FabLabUChile/modi/README.md

modi
====

cheap and fast building robot for swarm behavior research
