FabLabUChile/modi/Software/README.txt

### Software/README ###

The software section is divided in the tracking system and the software wich controls the MODI robot.

## Software/Tracking/ ##

Contains the fiducials images and software to track the MODI robot position from an online video input.

## Software/MODI/ ##

Contains the software to be loaded into the arduino onboard each MODI module.
