FabLabUChile/modi/thesis/main.tex

% LaTeX Template
% Version 1.3 (21/12/12)
%
% This template has been downloaded from:
% http://www.latextemplates.com
%
% Original authors:
% Steven Gunn 
% http://users.ecs.soton.ac.uk/srg/softwaretools/document/templates/
% and
% Sunil Patel
% http://www.sunilpatel.co.uk/thesis-template/
%
% License:
% CC BY-NC-SA 3.0 (http://creativecommons.org/licenses/by-nc-sa/3.0/)
%
% Note:
% Make sure to edit document variables in the Thesis.cls file
%
%%%%%%%%%%%%%%%%%%%%%%%%%%%%%%%%%%%%%%%%%

%----------------------------------------------------------------------------------------
%	PACKAGES AND OTHER DOCUMENT CONFIGURATIONS
%----------------------------------------------------------------------------------------

\documentclass[11pt, a4paper, oneside]{Thesis} % Paper size, default font size and one-sided paper

\usepackage[utf8]{inputenc}
\usepackage[section]{placeins}

\graphicspath{{./Pictures/}} % Specifies the directory where pictures are stored

\usepackage[square, numbers, comma, sort&compress]{natbib} % Use the natbib reference package - read up on this to edit the reference style; if you want text (e.g. Smith et al., 2012) for the in-text references (instead of numbers), remove 'numbers' 
\hypersetup{urlcolor=blue, colorlinks=true} % Colors hyperlinks in blue - change to black if annoying
\title{\ttitle} % Defines the thesis title - don't touch this

\begin{document}

\frontmatter % Use roman page numbering style (i, ii, iii, iv...) for the pre-content pages

\setstretch{1.3} % Line spacing of 1.3

% Define the page headers using the FancyHdr package and set up for one-sided printing
\fancyhead{} % Clears all page headers and footers
\rhead{\thepage} % Sets the right side header to show the page number
\lhead{} % Clears the left side page header

\pagestyle{fancy} % Finally, use the "fancy" page style to implement the FancyHdr headers

\newcommand{\HRule}{\rule{\linewidth}{0.5mm}} % New command to make the lines in the title page

% PDF meta-data
\hypersetup{pdftitle={\ttitle}}
\hypersetup{pdfsubject=\subjectname}
\hypersetup{pdfauthor=\authornames}
\hypersetup{pdfkeywords=\keywordnames}

%----------------------------------------------------------------------------------------
%	TITLE PAGE
%----------------------------------------------------------------------------------------

\begin{center}
\linespread{1.15}
\textbf{\large{UNIVERSIDAD TÉCNICA FEDERICO SANTA MARÍA\\}
\normalsize{DEPARTAMENTO DE ELECTRÓNICA\\VALPARAÍSO - CHILE\\}}

\vspace{0.5cm}
\begin{figure}[!ht]
\centering
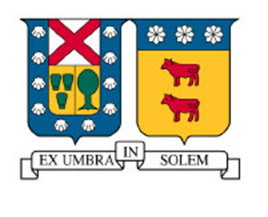
[picture p1: thesis/Figures/usmLogo.png]
  
\end{figure}
\vspace{0.5cm}

\linespread{1}\hangindent=0cm
\textbf{\Large ``DISEÑO Y CONSTRUCCIÓN DE PLATAFORMA PARA ESTUDIO DE ENJAMBRES DE ROBOTS''\\}
\vspace{3cm}

\hangindent=0cm\large \textbf{SEBASTIÁN IGNACIO SÁEZ SAN JUAN}\\
\vspace{0.5cm}
\hangindent=0cm\normalsize \textbf{MEMORIA DE TITULACIÓN PARA OPTAR AL TÍTULO DE INGENIERO CIVIL ELECTRÓNICO}\\
\vspace{3cm}

\vspace{0.5cm}
\begin{figure}[!ht]
\centering
  
\end{figure}
\vspace{0.5cm}

%\hangindent=0cm\normalsize \textbf{PROFESOR GUIA: \hspace{1cm} DRA. MARÍA JOSE ESCOBAR}\\
%\vspace{0.5cm}
%\hangindent=0cm\normalsize \textbf{PROFESOR CORREFERENTE: \hspace{1cm} DR. PABLO PRIETO}\\
%\vspace{0.5cm}
%\hangindent=0cm\normalsize \textbf{PROFESOR CORREFERENTE: \hspace{1cm} DR. JUAN CRISTOBAL ZAGAL}\\

\end{center}
%
%\begin{center}
%
%\textsc{\LARGE \univname}\\[1.5cm] % University name
%\textsc{\Large Memoria Titulación}\\[0.5cm] % Thesis type
%
%\HRule \\[0.4cm] % Horizontal line
%{\huge \bfseries \ttitle}\\[0.4cm] % Thesis title
%\HRule \\[1.5cm] % Horizontal line
% 
%\begin{minipage}{0.4\textwidth}
%\begin{flushleft} \large
%\emph{Autor:}\\
%\end{flushleft}
%\end{minipage}
%\begin{minipage}{0.4\textwidth}
%\begin{flushright} \large
%\emph{Supervisores:} \\
%\end{flushright}
%\end{minipage}\\[3cm]
% 
%\large \textit{Memoria para optar al grado de \degreename}\\[0.3cm] % University requirement text
%\textit{en el}\\[0.4cm]
%\deptname\\[2cm] % Research group name and department name
% 
%{\large \today}\\[4cm] % Date
%%\includegraphics{Logo} % University/department logo - uncomment to place it
% 
%\vfill
%\end{center}

%----------------------------------------------------------------------------------------
%	DECLARATION PAGE
%	Your institution may give you a different text to place here
%----------------------------------------------------------------------------------------

%----------------------------------------------------------------------------------------
%	QUOTATION PAGE
%----------------------------------------------------------------------------------------

%----------------------------------------------------------------------------------------
%	ABSTRACT PAGE
%----------------------------------------------------------------------------------------

\addtotoc{Resumen} % Add the "Abstract" page entry to the Contents

\resumen{\addtocontents{toc}{\vspace{1em}} % Add a gap in the Contents, for aesthetics
Desarrollo de una plataforma, de bajo costo, que permita estudiar el comportamiento de grupos de robots. Para que la plataforma funcione es necesario el diseño y construcción de los robots , implementar sistema de tracking 2D, armar la red de comunicación (XBee) y construir el software de control.
}

\clearpage % Start a new page

%----------------------------------------------------------------------------------------
%	ABSTRACT PAGE
%----------------------------------------------------------------------------------------

\addtotoc{Abstract} % Add the "Abstract" page entry to the Contents

\abstract{\addtocontents{toc}{\vspace{1em}} % Add a gap in the Contents, for aesthetics
Create a low cost platform, which allows to study the behavior of a group of robots. For this platform to work, it is necessary the design and building of the robots, implement a 2D tracking system, build a communication network (xbee) and create the control software.
}

\clearpage % Start a new page

%----------------------------------------------------------------------------------------
%	ACKNOWLEDGEMENTS
%----------------------------------------------------------------------------------------

\setstretch{1.3} % Reset the line-spacing to 1.3 for body text (if it has changed)

\acknowledgements{\addtocontents{toc}{\vspace{1em}} % Add a gap in the Contents, for aesthetics 

Este trabajo no habría podido realizarse sin el apoyo incondicional de mi profesora tutora, Dra. María José Escobar que ha tenido una gran paciencia conmigo y siempre me ha ayudado en lo posible. También fue fundamental el apoyo del Dr. Juan Cristóbal Zagal que gentilmente me permitió trabajar en su innovador laboratorio de Síntesis de máquinas inteligentes. No menos importante fue el apoyo del Dr. Pablo Prieto que ha sido un guía para mí en el diseño del robot. Además de ellos conté con la ayuda de muchas personas que han dedicado parte de su tiempo a escuchar mis ideas y aconsejarme. Es por esto que quiero agradecer a Jaime Martínez por ayudarme a diseñar el PCB de MODI, Carlos Galáz por sus inacabables minutos telefónicos para discutir casi todos los aspectos de MODI, Fabián Rubilar por sus ideas de como mover los robots, Linus Casassa por su paciencia para explicarme cualquier cosa sobre electrónica, la gente del taller de electrónica por enseñarme a soldar y sacarme de apuros técnicos, Ricardo Pérez por las interminables discusiones sobre el robot, mis compañeros del laboratorio de Sintesís de máquinas inteligentes y a mi amada Pía que siempre ha estado ahí conmigo siendo un gran apoyo en mi vida.
}
\clearpage % Start a new page

%----------------------------------------------------------------------------------------
%	LIST OF CONTENTS/FIGURES/TABLES PAGES
%----------------------------------------------------------------------------------------

\pagestyle{fancy} % The page style headers have been "empty" all this time, now use the "fancy" headers as defined before to bring them back

\lhead{\emph{Contents}} % Set the left side page header to "Contents"
\tableofcontents % Write out the Table of Contents

\lhead{\emph{Índice de Figuras y Tablas}} % Set the left side page header to "List of Figures"
\listoffigures % Write out the List of Figures

%----------------------------------------------------------------------------------------
%	DEDICATION
%----------------------------------------------------------------------------------------

\setstretch{1.3} % Return the line spacing back to 1.3

\pagestyle{empty} % Page style needs to be empty for this page

\dedicatory{Pía, mi fiel compañera de aventuras\ldots} % Dedication text

\addtocontents{toc}{\vspace{2em}} % Add a gap in the Contents, for aesthetics
\addcontentsline{toc}{chapter}{Prefacio}

%----------------------------------------------------------------------------------------
%	THESIS CONTENT - CHAPTERS
%----------------------------------------------------------------------------------------

\mainmatter % Begin numeric (1,2,3...) page numbering

\pagestyle{fancy} % Return the page headers back to the "fancy" style

% Include the chapters of the thesis as separate files from the Chapters folder
% Uncomment the lines as you write the chapters

\input{./Chapters/Prefacio}
\input{./Chapters/Chapter1} 
\input{./Chapters/Chapter2}
\input{./Chapters/Chapter3}
\input{./Chapters/Chapter4} 
\input{./Chapters/Chapter5} 
\input{./Chapters/Chapter6}
\input{./Chapters/Chapter7}

%----------------------------------------------------------------------------------------
%	THESIS CONTENT - APPENDICES
%----------------------------------------------------------------------------------------

\addtocontents{toc}{\vspace{2em}} % Add a gap in the Contents, for aesthetics

\appendix % Cue to tell LaTeX that the following 'chapters' are Appendices

% Include the appendices of the thesis as separate files from the Appendices folder
% Uncomment the lines as you write the Appendices

\input{./Appendices/AppendixA}
%\input{./Appendices/AppendixB}
%\input{./Appendices/AppendixC}

\addtocontents{toc}{\vspace{2em}} % Add a gap in the Contents, for aesthetics

\backmatter

%----------------------------------------------------------------------------------------
%	BIBLIOGRAPHY
%----------------------------------------------------------------------------------------

\label{Bibliography}
%Renombrar pagina
\renewcommand{\bibname}{Referencias}
\renewcommand{\refname}{Referencias}

\lhead{\emph{Bibliography}} % Change the page header to say "Bibliography"

\bibliographystyle{unsrtnat} % Use the "unsrtnat" BibTeX style for formatting the Bibliography

\bibliography{Bibliography} % The references (bibliography) information are stored in the file named "Bibliography.bib"

\end{document}
