FabLabUChile/modi/thesis/Chapters/Chapter3.tex

% Chapter Template

\chapter{Swarm} % Main chapter title

\label{Chapter3} % Change X to a consecutive number; for referencing this chapter elsewhere, use \ref{ChapterX}

\lhead{Capítulo 3. \emph{Swarms}} % Change X to a consecutive number; this is for the header on each page - perhaps a shortened title

\begin{figure}[htbp]
	\centering
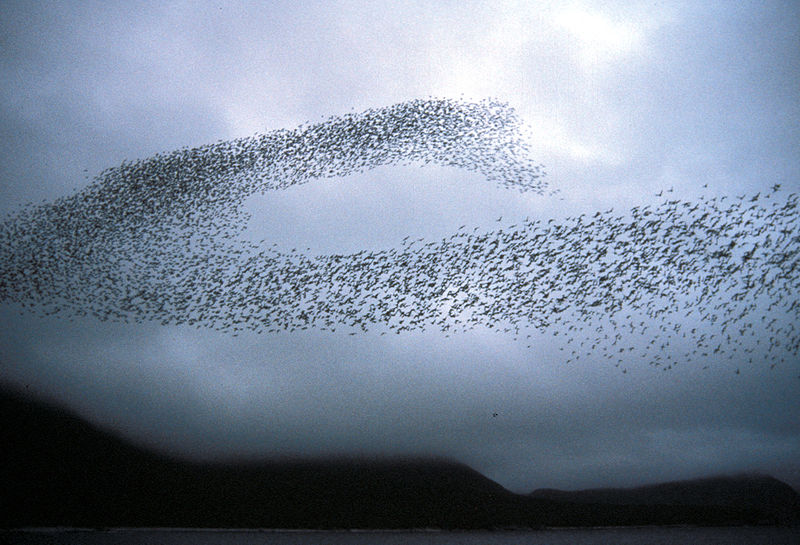
[picture p28: thesis/Figures/swarm.jpg]
		
	%	\rule{35em}{0.5pt}
	%\caption[Bandada de auklets]{Bandada de auklets teniendo comportamiento de enjambre. Imagen tomada de Wikipedia.}
	\label{fig:Bandada}
\end{figure}

El comportamiento colectivo de sistemas descentralizados, auto-organizados es llamado Inteligencia de Enjambre. Estos sistemas están formados típicamente por una población de individuos simples que interactúan entre ellos localmente y con su medio ambiente. Estos individuos siguen reglas muy simples, y pese a no tener una estructura de control centralizado que dicte cómo deben comportarse individualmente,  las interacciones entre los individuos conducen a la aparición de cierta inteligencia en el comportamiento global.

%----------------------------------------------------------------------------------------
%	SECTION 1
%----------------------------------------------------------------------------------------

\section{Comportamiento colectivo en la naturaleza}

En la naturaleza existen diversos casos de comportamiento colectivo. Los enjambres más típicos son las hormigas y abejas, pero los hay en peces, aves e incluso los mamíferos. Son sistemas donde nadie está a cargo y aún así ejecutan una tarea grupal. Las hormigas son un gran ejemplo. Al momento de construir su madriguera, no tienen un arquitecto o ingeniero estructural que esté dando órdenes, simplemente cada una sabe qué tiene que hacer. No hay un director orquestando la construcción desde lo alto, en vez de esto lo que ocurre es un comportamiento emergente. También conocido como inteligencia de enjambre\cite{bonabeau1999swarm}.

Otro tipo de comportamiento colectivo son las migraciones, desplazamientos periódicos que efectúan aves, peces, langostas y mamíferos de un hábitat a otro. Cada individuo activo en la migración sigue al grupo, los más pequeños como el plancton o anfibios aprovechan las corrientes de aire o agua, y las aves, más grandes, aprovechan los vientos y corrientes ascendentes. Hay diversas finalidades detrás de la migración, algunas especies lo hacen para escaparse de los crudos inviernos o secos veranos; mientras que otras, como las tortugas marinas, por una necesidad reproductiva emprenden un largo viaje de más de 10.000 millas, a lo largo de todo el Atlántico Norte.

Lograr que un enjambre de robots tenga un comportamiento emergente como el de las colonias de abejas es lo que están buscando investigadores de esta área. Uno de los más destacados investigadores del área James McLurkin, experto en robótica del Massachusetts Institute of Technology (MIT), dice que para lograrlo es necesario un software que ejecute tareas individuales y que de alguna forma se cumpla con una tarea grupal \cite{mclurkin2007distributed}. He aquí una importante razón para desarrollar estudios sobre enjambres de robots, ya que aún no está claro cómo se coordina la naturaleza para llevar a cabo tales tareas. Un ejemplo es el algoritmo Optimización de colonia de hormigas, que es una clase de algoritmos inspirado en las acciones de una colonia de hormigas y como hacen uso de la feromona. Su principal uso es en problemas donde se necesite encontrar caminos hacia una meta, simulando las feromonas para dirigir a cada uno de los individuos en la búsqueda. Utilizando este tipo de estrategia es posible que en un futuro no muy lejano se pueda utilizar para controlar nanobots dentro del cuerpo con el fin de eliminar los tumores del cáncer.

%-----------------------------------
%	SECTION 2
%-----------------------------------
\section{Robots para construir un enjambre}

Diferentes laboratorios del mundo han desarrollado robots que funcionan como enjambre, con diseños que satisface sus propios requerimientos. Dependiendo de ellos varían en costo, tamaño y funcionalidad.

Algunos robots que pueden ser utilizados para hacer un Robot Swarm junto con las información técnica disponible, son listados en la sub secciones siguientes.

%-----------------------------------
%	SUBSECTION 1
%-----------------------------------
\subsection{Kilobot}
El proyecto Kilobot, ver Figura \ref{fig:robots estudiados} a, es un sistema de bajo costo escalable para demostrar comportamientos colectivos. Actualmente el grupo Self-organizing Systems Research Group \footnote{http://www.eecs.harvard.edu/ssr/index.html} , de la Universidad de Harvard, está investigando algoritmos para enjambres de robots, por esto diseñó Kilobot, que es un robot de bajo costo, accesible,  que permite hacer pruebas en cientos o miles de robots. Con estos robots investigan temas como: encontrar "alimento" de forma grupal, seguir al líder y dispersarse unos de otro. Su principal característica es que son muy pequeños y simples de usar. Las desventajas de Kilobots son: su sistema de locomoción que obliga a tener una superficie extremadamente lisa para usarlos y que no poseen sistema de radio que permita en control de forma inalámbrica, solo comunicación local.

%-----------------------------------
%	SUBSECTION 2
%-----------------------------------
\subsection{Organismo Multibot}
S. Kornienko et al. \cite{5359578}, exploran el trabajo colaborativo en robots para un mejor rendimiento y mayor fiabilidad a nivel macroscópico. En este artículo demuestran sus últimos trabajos en sistemas colectivos y lo más sorprendente es que logran la agregación y desagregación autónoma para así obtener un organismo multibot. Este robot tiene la ventaja de tener un mecanismo que le permite unirse mecánicamente, pero también puede compartir energía, sensores y lógica con otros robots iguales para formar un organismo que es capaz de modificar su estructura y adaptarse al entorno auto-organizándose. En la Figura \ref{fig:robots estudiados} b, se puede ver una estructura formada por los robots. De los robots estudiados este es el único que posee esta capacidad de unirse de manera autónoma ya que su hardware fue concebido para tales fines, pero no representa una ventaja porque se acotó la búsqueda a robots con desplazamiento diferencial. Estos robots no cuentan con documentación detallada ni distribuidores que los vendan, al parecer están descontinuados.

%-----------------------------------
%	SUBSECTION 3
%-----------------------------------
\subsection{e-puck}
Uno de los robots más utilizados por los científicos en el mundo para estudios y publicaciones es el e-puck \cite{mondada2009puck}. Este robot es compacto, tiene forma de cilindro con un diámetro de 7 [cm] y para moverse hace uso de sus dos ruedas, dejándolo en la categoría de robot con desplazamiento diferencial. Originalmente fue diseñado para educar en el área de la micro ingeniería por Michael Bonani y Francesco Mondala en el laboratorio ASL del Profesor Roland Siegwart en Escuela Politécnica Federal de Lausana (EPFL) en Suiza. El e-puck es open hardware, su software es de código abierto,  lo construyen y venden varias empresas. Para comunicarse con un computador incorporan un módulo Bluetooth conectado a uno de sus dos puertos serie. Existen varios tipos de accesorios, entre los que destacan un Zigbee para comunicaciones, un módulo con varias cámaras y LEDs RGB como sistema de comunicación visual. Su principal desventaja es el alto precio y por lo mismo su uso está algo descontinuado. Además son complejos de programar y se necesita una licencia especial para su software.

%-----------------------------------
%	SUBSECTION 4
%-----------------------------------
\subsection{3pi Robot}

El 3pi fue diseñado especialmente como un robot seguidor de líneas y capaz de solucionar laberintos. Existen varios vídeos que muestran la asombrosa velocidad de estos robots para solucionar un laberinto \footnote{http://www.pololu.com/catalog/product/975}. Se programa en C, pero como posee un microcontrolador ATmega es posible hacer uso del bootloader Arduino y programarlo con ese IDE. Usa 4 baterías AAA y trae 4 LEDs.  Yi-Jen Mon1 utilizó estos robots para desarrollar Supervisory Adaptive Network-Based Fuzzy Inference System (SANFIS) de forma empírica en un robot móvil, no simulado en un computador. Sus desventajas son: No cuenta con un sistema de carga autónoma, hardware extra que no va ser necesario para nuestros experimentos, necesita un cable especial para programarlo y no tiene comunicación inalámbrica.

\begin{figure}[htbp]
	\centering
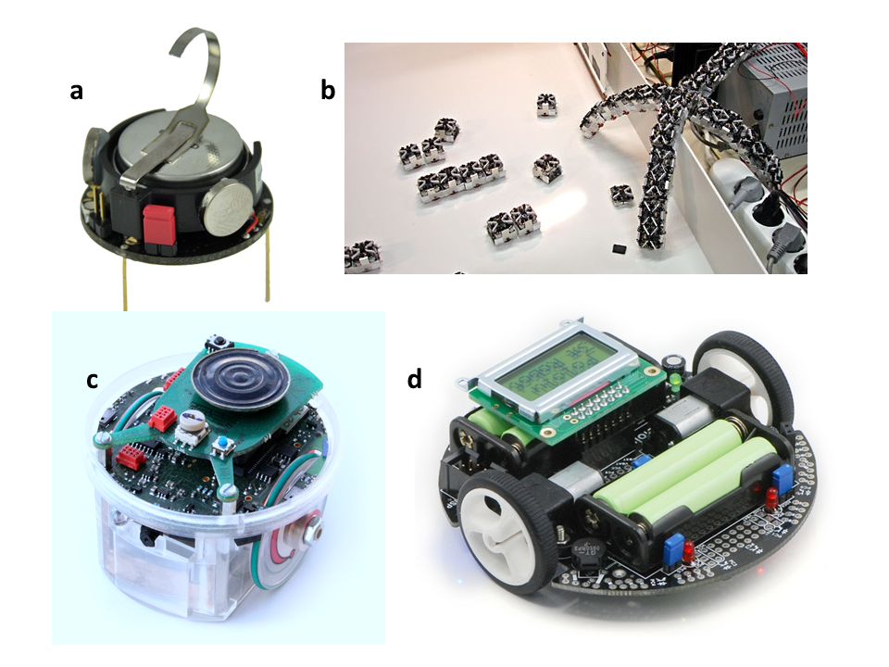
[picture p29: thesis/Figures/robots1.png]
		
		\rule{35em}{0.5pt} 
	\caption[Robots estudiados como alternativa para armar un enjambre de robots.]{\textbf{a.} Kilobot, el más simple de todos y pequeño. Imagen tomada de \cite{6224638}. \textbf{b.} Organismo Multibot, permite armar estructuras con los robots. Imagen tomada de \cite{5359578}. \textbf{c.} e-puck, robot altamente difundido en investigaciones, caro y complejo. Imagen tomada de \cite{mondada2009puck}. \textbf{d.} 3pi Robot, simple y económico pero no tiene comunicación inalámbrica. Imagen tomada de \cite{thurskyusing}}
	\label{fig:robots estudiados}
\end{figure}

En la Figura \ref{fig:Tabla robots} hay una tabla comparativa que resume las principales características de los robot: Kilobot\footnote{http://www.k-team.com/mobile-robotics-products/kilobot/specifications}, e-puck\footnote{http://www.gctronic.com/doc/index.php/E-Puck} y 3pi\footnote{http://www.pololu.com/catalog/product/975/specs}. Lamentablemente para el multibot no es mucha la información disponible.

\begin{figure}[htbp]
	\centering
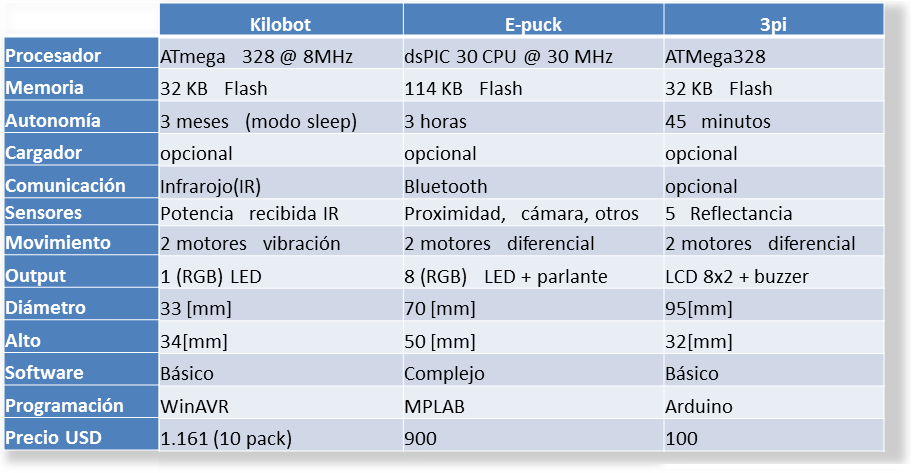
[picture p30: thesis/Figures/tabla_robots.png]
		
		\rule{35em}{0.5pt}
	\caption[Tabla comparativa robots]{En esta tabla se comparan las características principales de los robots: kilobot, e-puck y 3pi. No se incluyó el robot utilizado para el organismo multibot ya que no se comercializa.}
	\label{fig:Tabla robots}
\end{figure}

En esta tabla se comparan tres robots que pueden usarse para hacer estudios de enjambres de robots. De acá se resume que kilobot es un robot simple que no tiene comunicación inalámbrica, E-puck es un robot sumamente completo con un alto costo y está sobredimencionado para los estudios que se quieren hacer. El que más se acerca a nuestros requerimientos es el 3Pi de Pololu, pero cuenta con hardware extra que aumenta su consumo energético y no incorpora ningún sistema de comunicación inalámbrica.

\FloatBarrier
Además existen otros robots que podrían utilizarse en este trabajo, pero que al momento del desarrollo no existian. En el repositorio de objetos 3D de MakelBot Thingiverse existe algunos. Tres que destacan por su simplicidad son: SlinkyBOT Lunar mini rover \footnote{http://www.thingiverse.com/thing:98091} Ver Figura \ref{fig:thingiverse} b, Econo1Bot for the RAMB motherboards \footnote{http://www.thingiverse.com/thing:83998}  Ver Figura \ref{fig:thingiverse} c. y MiniSkybot \footnote{http://www.thingiverse.com/thing:7989}  Ver Figura \ref{fig:thingiverse} c.
 
\begin{figure}[htbp]
	\centering
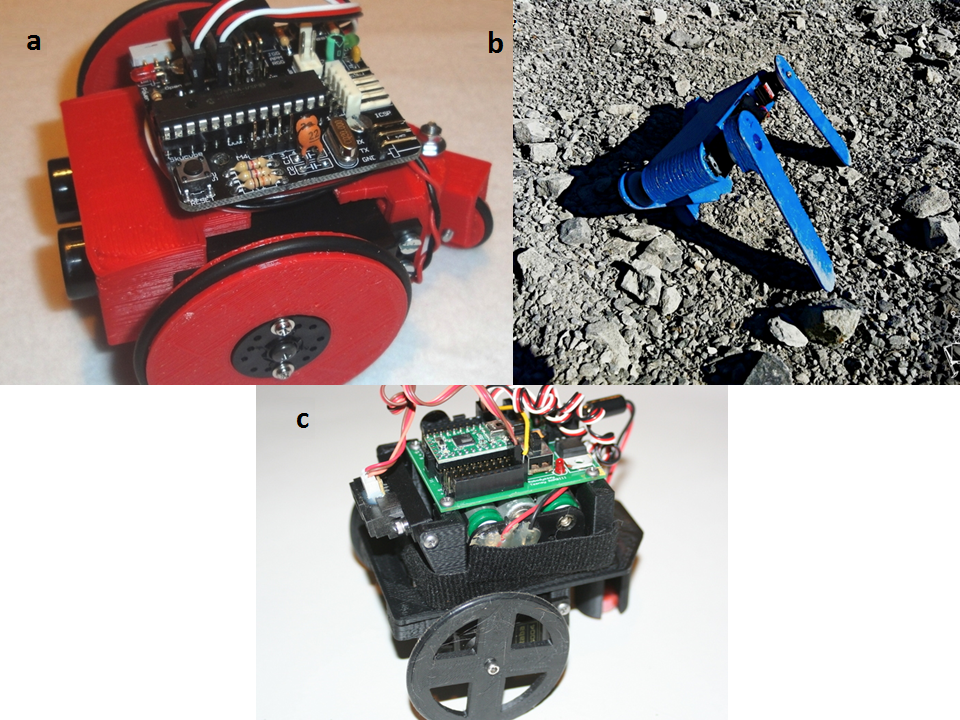
[picture p31: thesis/Figures/thingiverse.png]
		
		\rule{35em}{0.5pt}
	\caption[Robots en Thingiverse]{Robots que han sido subidos a la plataforma Thingiverse para que usuarios puedan descargar los modelos y construirlos. \textbf{a.} MiniSkybot, \textbf{b.}SlinkyBOT Lunar mini rover y \textbf{c.} Econo1Bot for the RAMB motherboards.}
	\label{fig:thingiverse}
\end{figure}

%-----------------------------------
%	SECTION 3
%-----------------------------------
\section{Necesidades de mercado}

De los robots estudiados destaca en sus prestaciones el e-puck, pero este tiene dos grandes problemas para ser usado por gente que no es especialista en robots. Uno es que tiene demasiado hardware, lo que tiende a confundir y aumentar costos. Dos, que para su comunicación inalámbrica hace uso de Bluetooth, protocolo que no soporta las redes Mesh para hacer de manera simple el control de muchos dispositivos en una red. Por otro lado el robot Kilobot es extremadamente simple, no permite mucha modificación y este con 3pi no tienen sistema de comunicación inalámbrica.

Hace falta un robot que no sobrepase los 200 USD, capaz de controlarse en forma inalámbrica, simple de construir y fácil de usar. Se requiere hacer uso de tecnologías como impresoras 3D y diseño Open Hardware para los robot que formen el enjambre. El tener un diseño compatible con las impresoras 3D facilita enormemente la difusión y distribución del proyecto, ya que cualquier persona con acceso a una impresora 3D puede replicar el robot. Y para hacer más simple el proceso de réplica y fomentar las mejoras en el proyecto, se requiere que tanto el hardware como el software sean Open, esto significa que cualquier persona puede acceder a los archivos de diseño del robot, copiarlos, redistribuirlo y modificarlo para que se adapte a sus necesidades. El nombre del robot será MODI que viene de las siglas del inglés Modular Intelligence. MODI quiere satisfacer el nicho de mercado donde se necesitan robots simples y de bajo precio, como se ve en la Figura \ref{fig:nicho}.

\begin{figure}[htbp]
	\centering
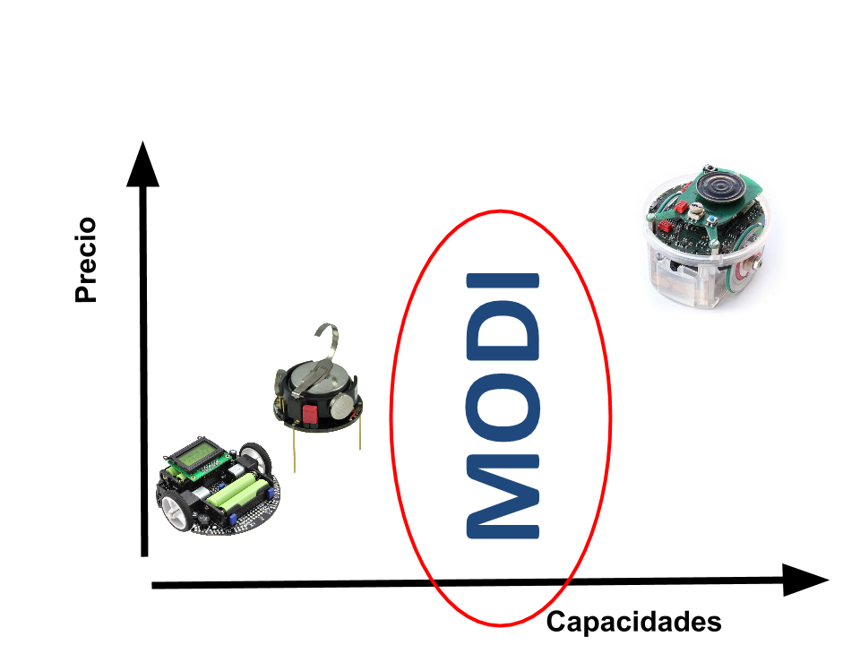
[picture p32: thesis/Figures/nicho.png]
		
		\rule{35em}{0.5pt}
	\caption[Nicho de mercado]{Nicho de mercado donde puede ingresar la plataforma robótica que se diseñó. Su nombre es MODI por las siglas en inglés de Modular Intelligence.}
	\label{fig:nicho}
\end{figure}
