FabLabUChile/modi/Hardware/Eagle/modi.png

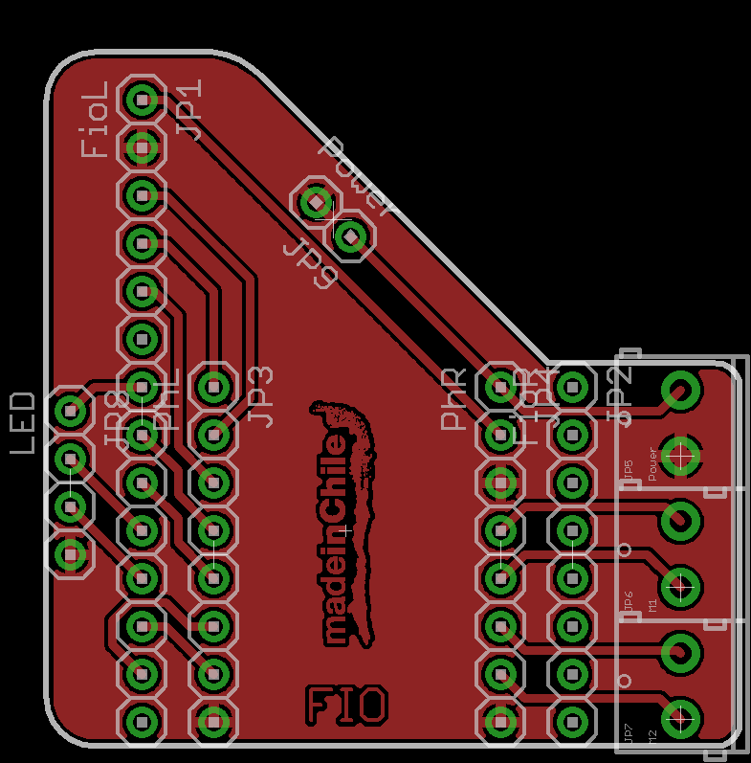
Hardware/Eagle/modi.png
