FabLabUChile/modi/Hardware/Eagle/MODIboard.png

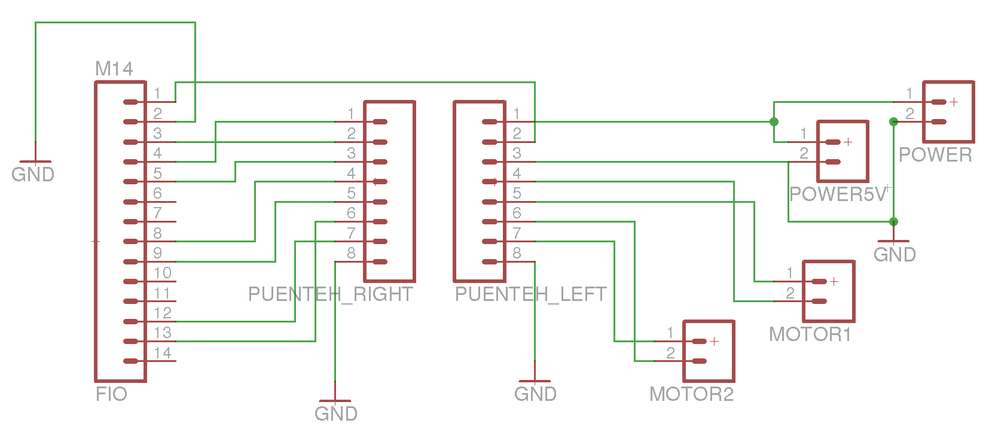
Hardware/Eagle/MODIboard.png
