FabLabUChile/modi/Hardware/Eagle/modiSLIM.png

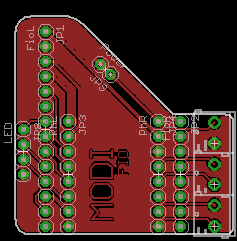
Hardware/Eagle/modiSLIM.png
