FabLabUChile/modi/Hardware/Eagle/TB6612FNG Breakout v11/TB6612FNG Breakout.png

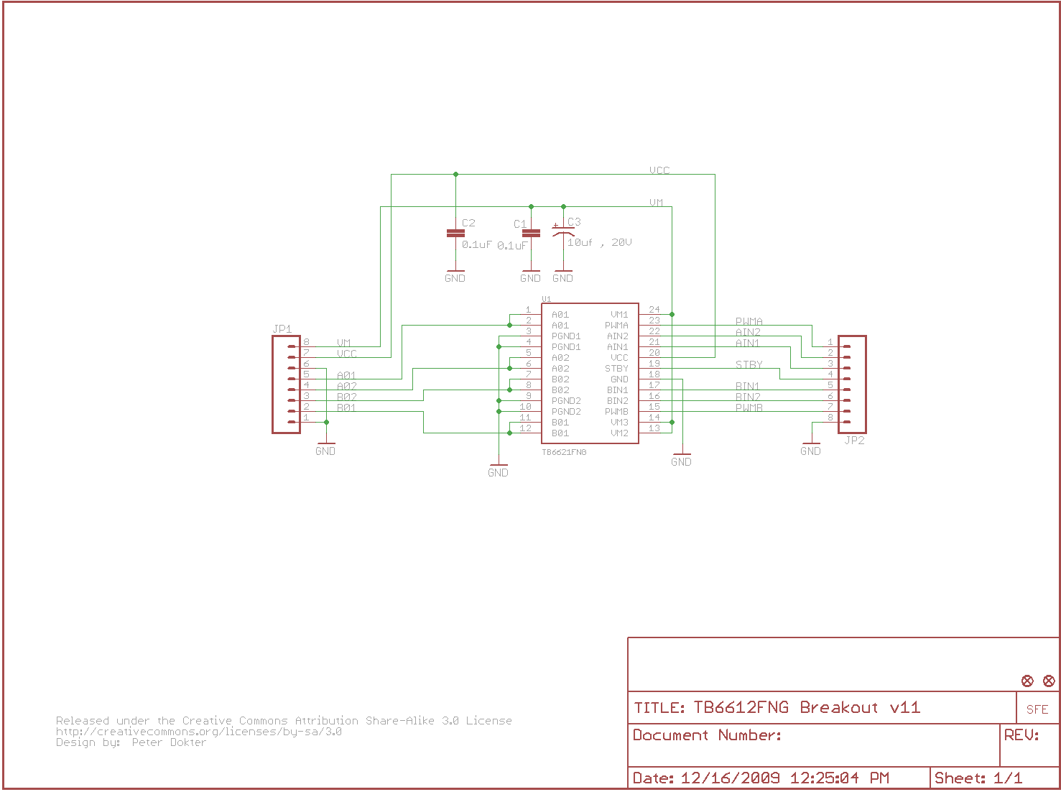
Hardware/Eagle/TB6612FNG Breakout v11/TB6612FNG Breakout.png
