FabLabUChile/modi/Media/images/pinocchio.jpg

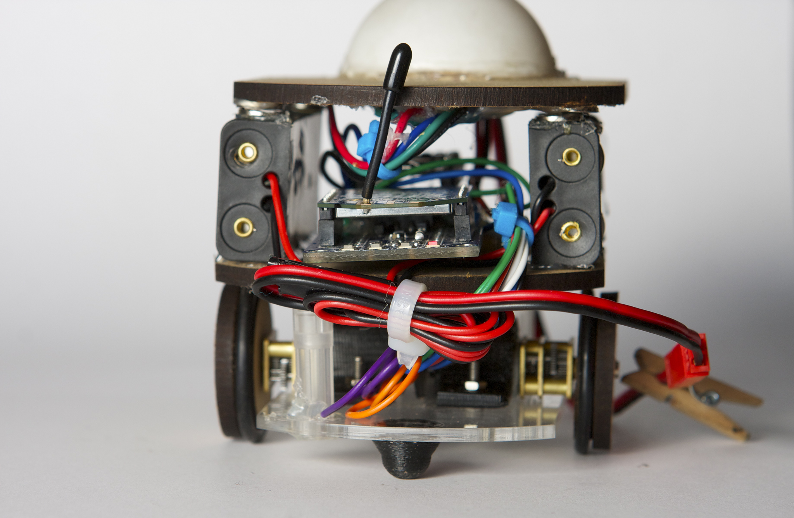
Media/images/pinocchio.jpg
