FabLabUChile/modi/thesis/Figures/3dtouch.jpg

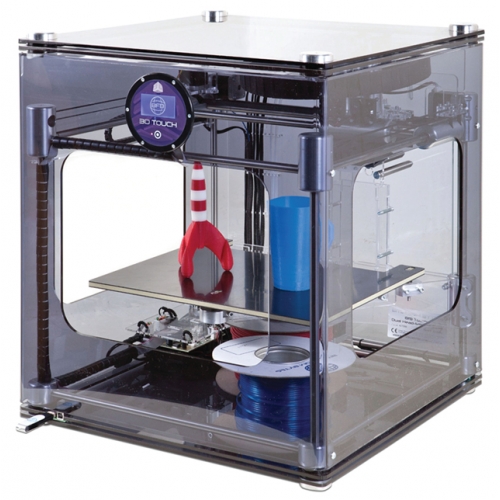
thesis/Figures/3dtouch.jpg
