FabLabUChile/modi/thesis/Figures/algoritmo_automodelo.png

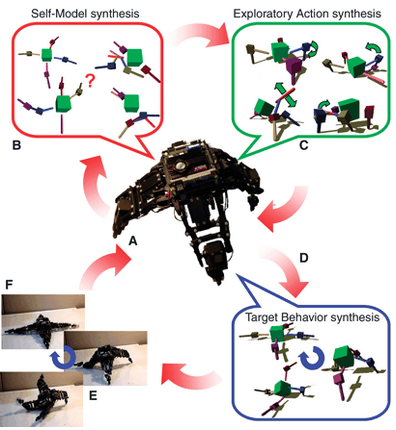
thesis/Figures/algoritmo_automodelo.png
