FabLabUChile/modi/thesis/Figures/arquitectura_cerebro.png

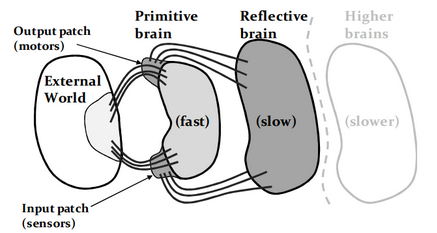
thesis/Figures/arquitectura_cerebro.png
