FabLabUChile/modi/thesis/Figures/automod.png

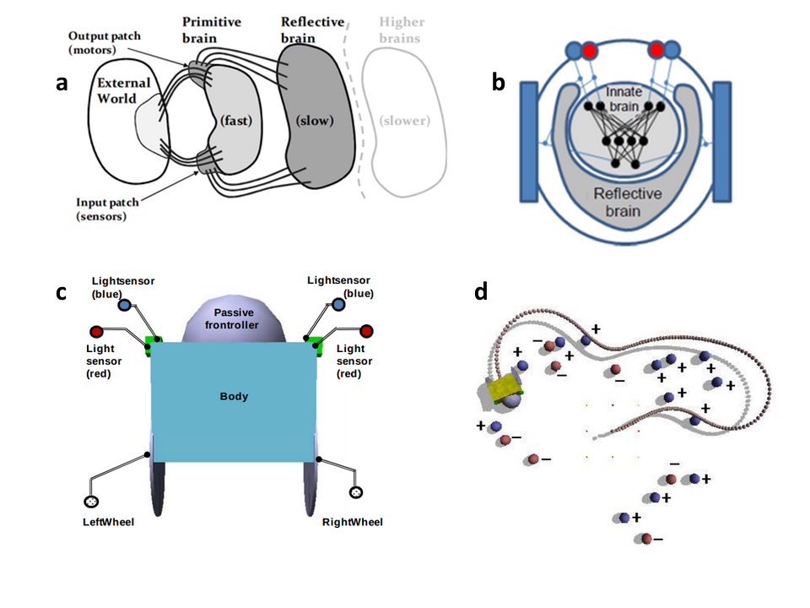
thesis/Figures/automod.png
