FabLabUChile/modi/thesis/Figures/automodelado_epuck.png

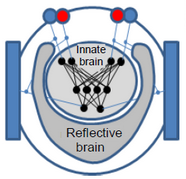
thesis/Figures/automodelado_epuck.png
