FabLabUChile/modi/thesis/Figures/Diagrama.jpg

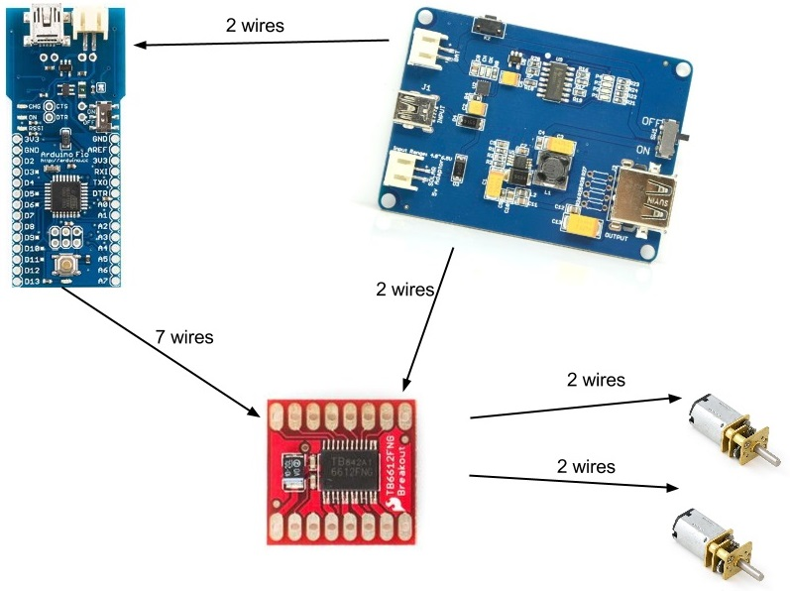
thesis/Figures/Diagrama.jpg
