FabLabUChile/modi/thesis/Figures/ExpPwm.png

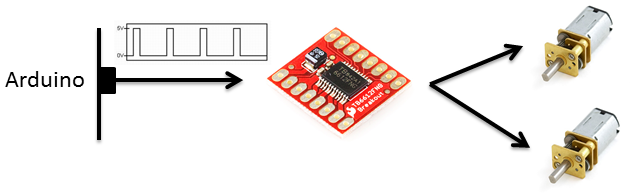
thesis/Figures/ExpPwm.png
