FabLabUChile/modi/thesis/Figures/implementacion.png

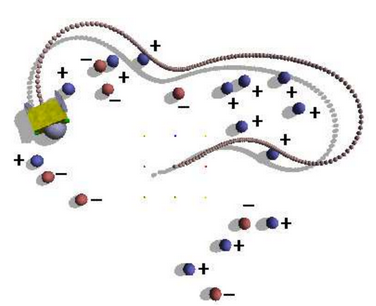
thesis/Figures/implementacion.png
