FabLabUChile/modi/thesis/Figures/MODI/1MODI.jpg

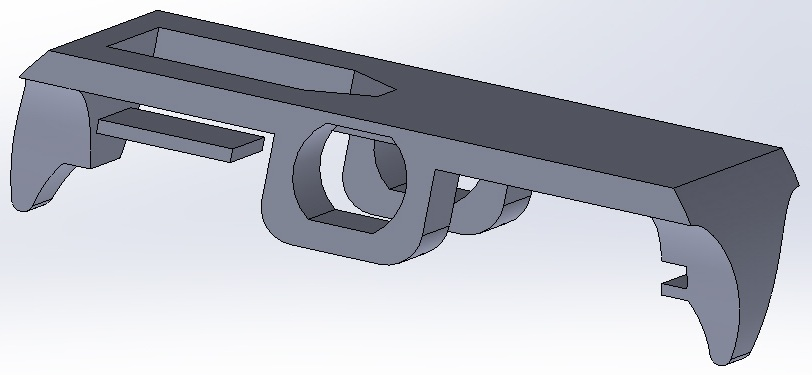
thesis/Figures/MODI/1MODI.jpg
