FabLabUChile/modi/thesis/Figures/MODI/accesorio.jpg

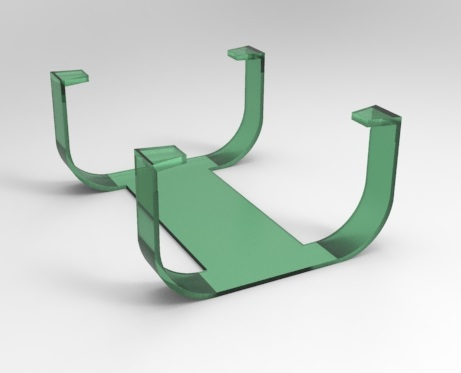
thesis/Figures/MODI/accesorio.jpg
