FabLabUChile/modi/thesis/Figures/MODI/bateria.jpg

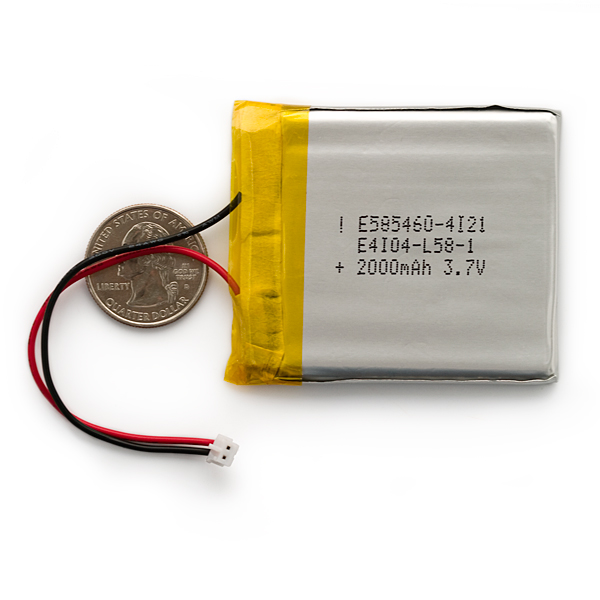
thesis/Figures/MODI/bateria.jpg
