FabLabUChile/modi/thesis/Figures/MODI/chasismodi.jpg

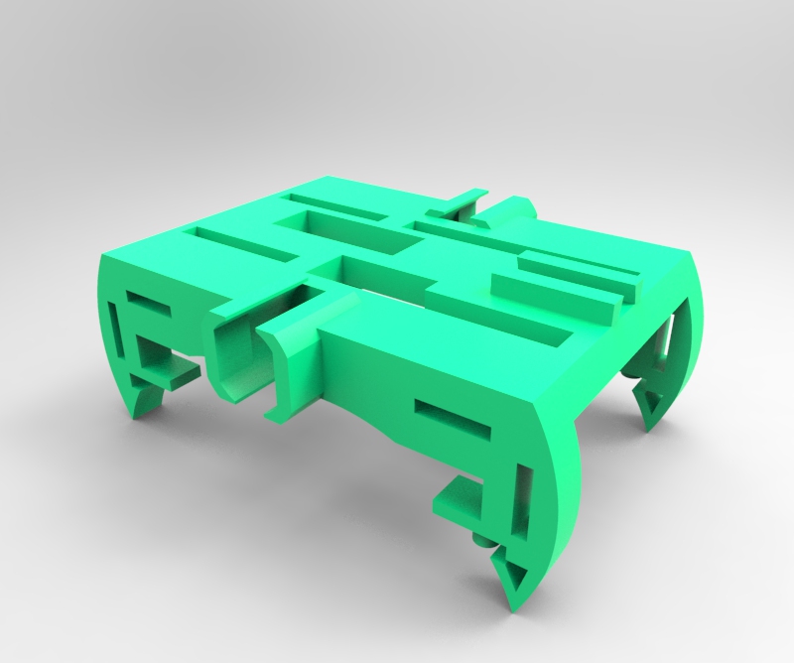
thesis/Figures/MODI/chasismodi.jpg
