FabLabUChile/modi/thesis/Figures/MODI/circuitoPCB.png

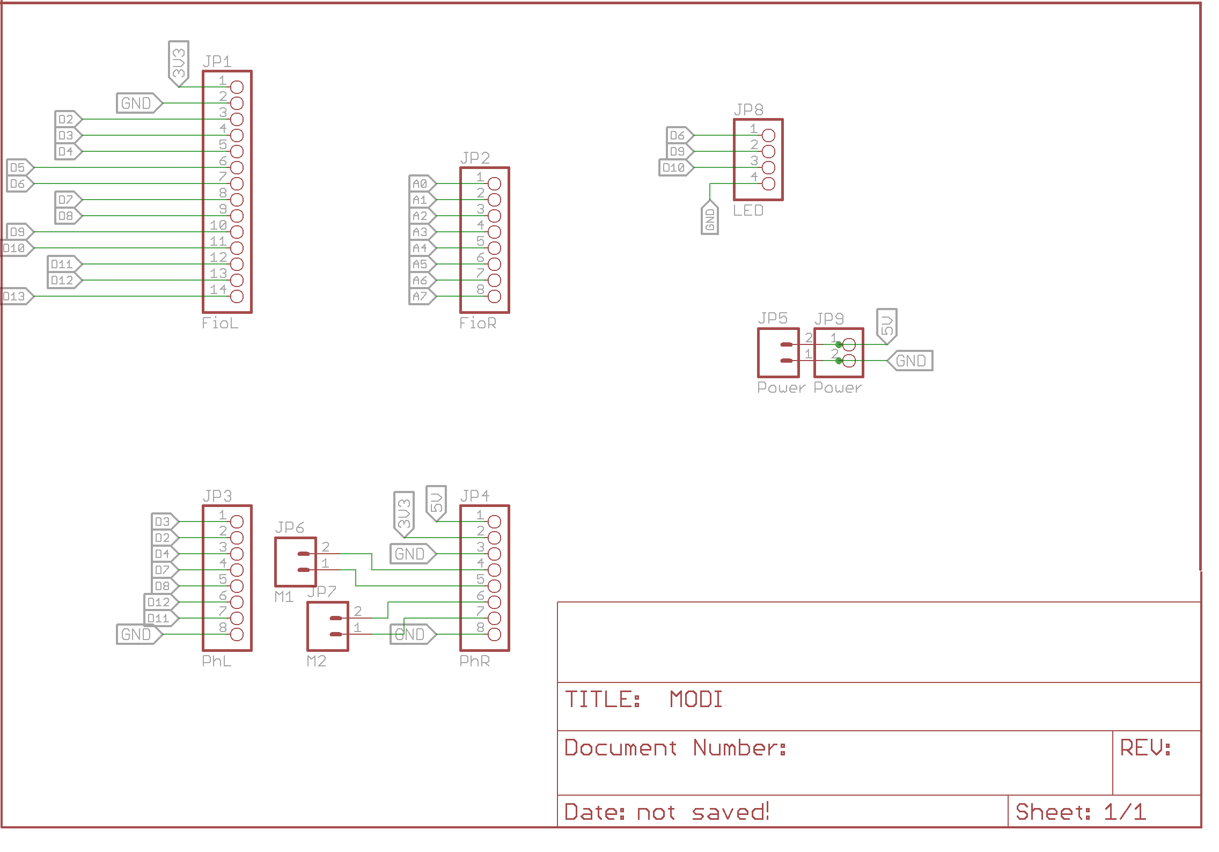
thesis/Figures/MODI/circuitoPCB.png
