FabLabUChile/modi/thesis/Figures/MODI/DCMotor.png

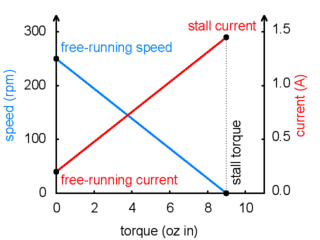
thesis/Figures/MODI/DCMotor.png
