FabLabUChile/modi/thesis/Figures/MODI/fio2.bmp

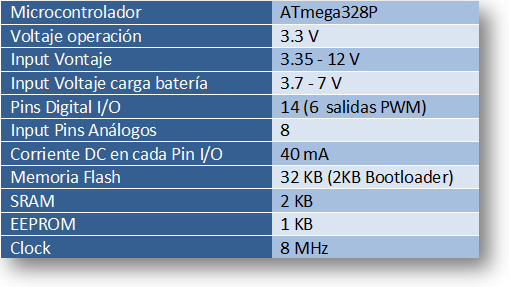
thesis/Figures/MODI/fio2.bmp
