FabLabUChile/modi/thesis/Figures/MODI/fio.png

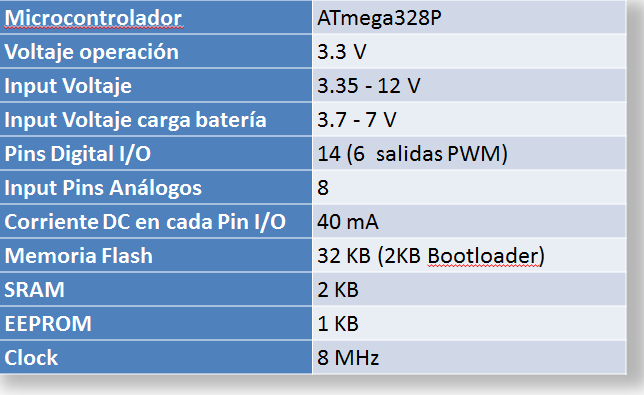
thesis/Figures/MODI/fio.png
