FabLabUChile/modi/thesis/Figures/MODI/lipopro.jpg

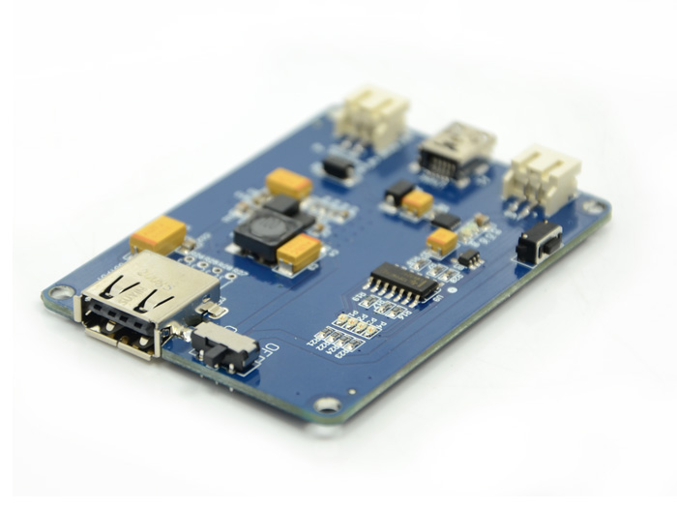
thesis/Figures/MODI/lipopro.jpg
