FabLabUChile/modi/thesis/Figures/MODI/modi2.png

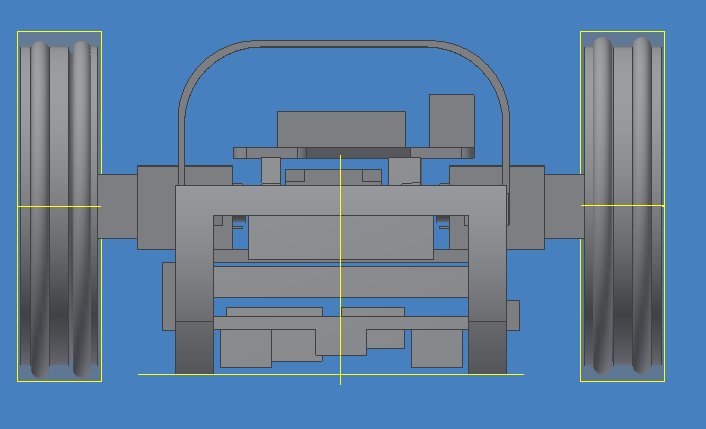
thesis/Figures/MODI/modi2.png
