FabLabUChile/modi/thesis/Figures/MODI/modi3.png

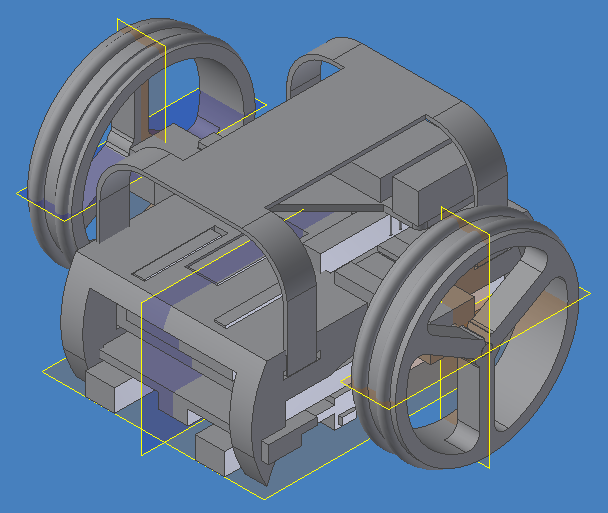
thesis/Figures/MODI/modi3.png
