FabLabUChile/modi/thesis/Figures/MODI/modi.png

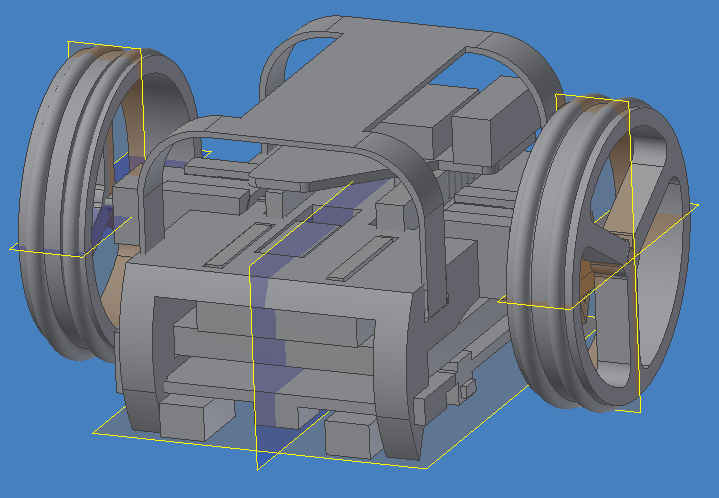
thesis/Figures/MODI/modi.png
