FabLabUChile/modi/thesis/Figures/MODI/Motorpololu.jpg

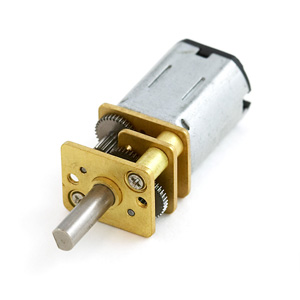
thesis/Figures/MODI/Motorpololu.jpg
