FabLabUChile/modi/thesis/Figures/MODI/render3.jpg

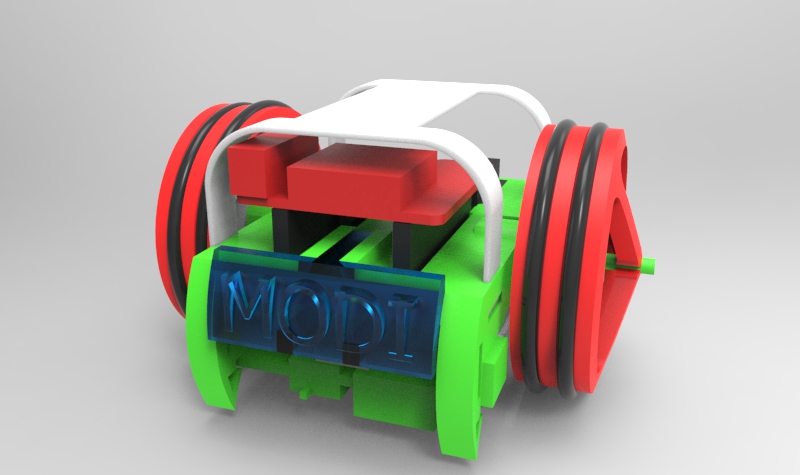
thesis/Figures/MODI/render3.jpg
