FabLabUChile/modi/thesis/Figures/MODI/RGBLED.jpg

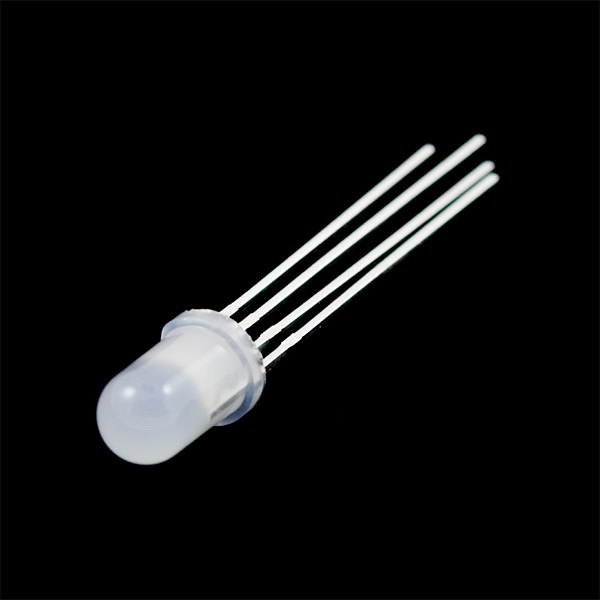
thesis/Figures/MODI/RGBLED.jpg
