FabLabUChile/modi/thesis/Figures/MODI/ruedamodi.jpg

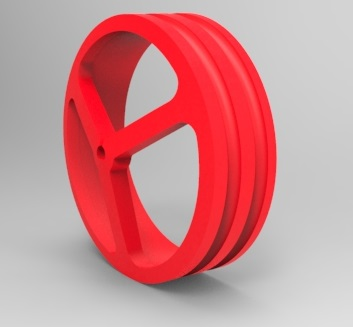
thesis/Figures/MODI/ruedamodi.jpg
