FabLabUChile/modi/thesis/Figures/MODI/TB6612FNG.jpg

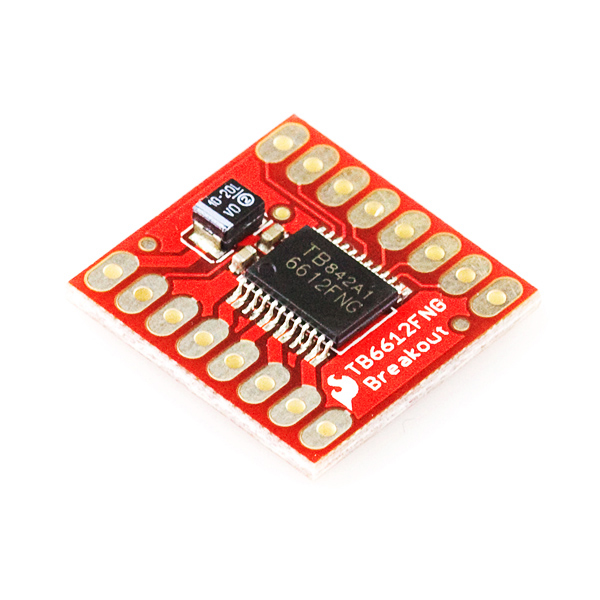
thesis/Figures/MODI/TB6612FNG.jpg
