FabLabUChile/modi/thesis/Figures/MODI/xbee.jpg

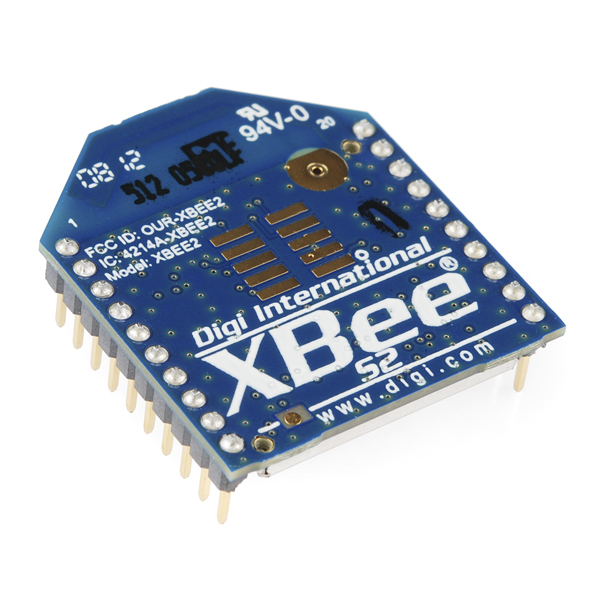
thesis/Figures/MODI/xbee.jpg
