FabLabUChile/modi/thesis/Figures/Multibot_organism.jpg

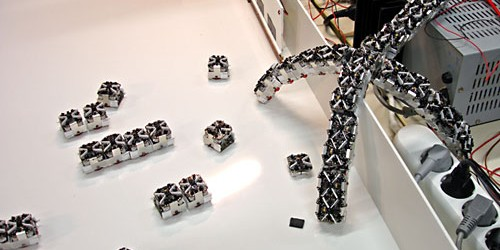
thesis/Figures/Multibot_organism.jpg
