FabLabUChile/modi/thesis/Figures/omni-directional-wheel-front-z.jpg

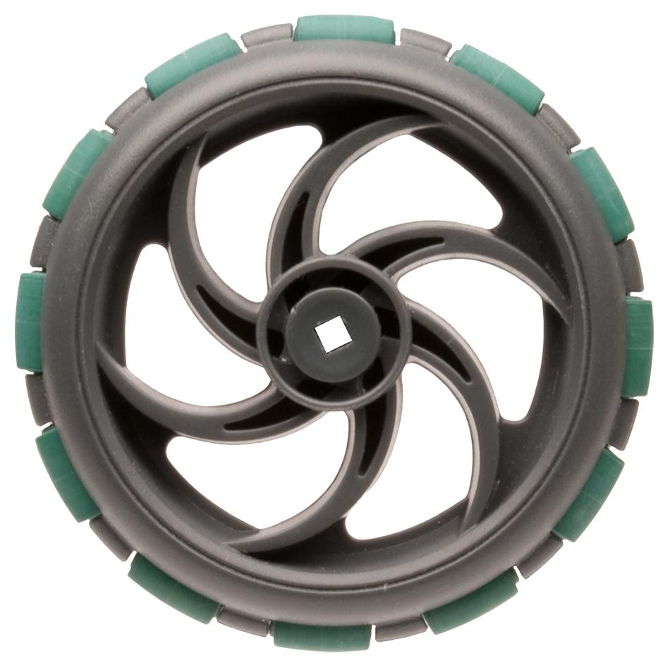
thesis/Figures/omni-directional-wheel-front-z.jpg
