FabLabUChile/modi/thesis/Figures/PR_KR1000_titan_01.jpg

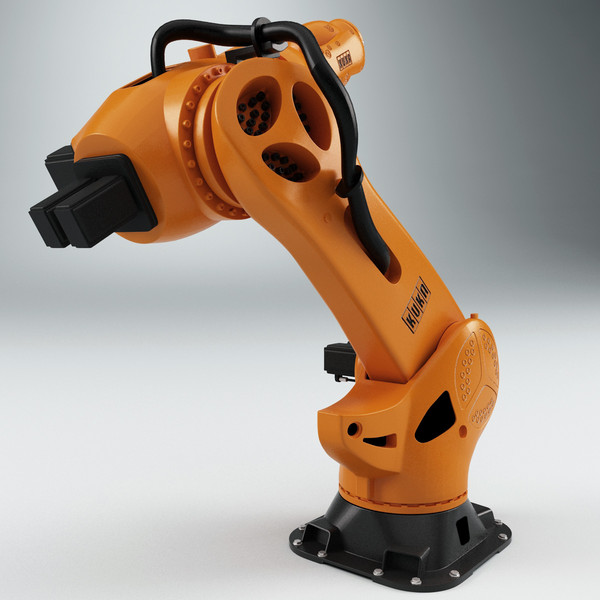
thesis/Figures/PR_KR1000_titan_01.jpg
