FabLabUChile/modi/thesis/Figures/pwmchart.png

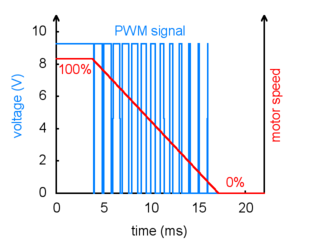
thesis/Figures/pwmchart.png
