FabLabUChile/modi/thesis/Figures/replicator1.jpg

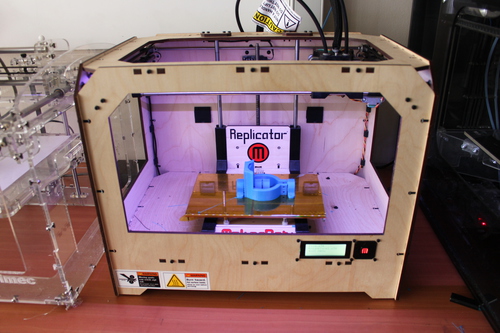
thesis/Figures/replicator1.jpg
