FabLabUChile/modi/thesis/Figures/roomba.png

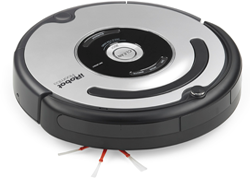
thesis/Figures/roomba.png
