FabLabUChile/modi/thesis/Figures/swarm_3_600.1.jpg

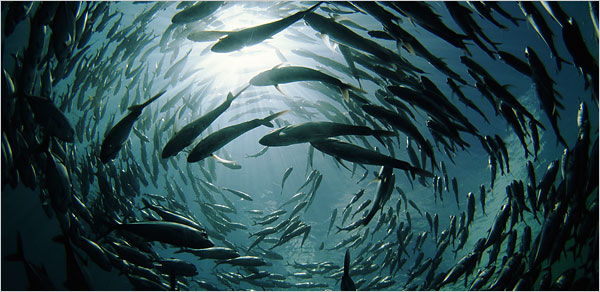
thesis/Figures/swarm_3_600.1.jpg
