FabLabUChile/modi/thesis/Pictures/2MODIrev2.jpg

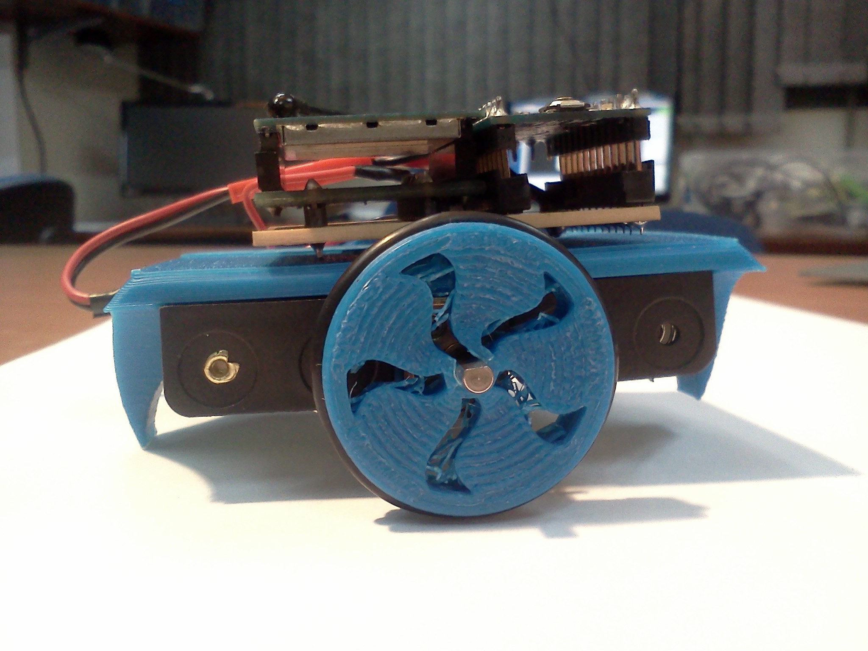
thesis/Pictures/2MODIrev2.jpg
