FabLabUChile/modi/thesis/Pictures/3MODIrev2.jpg

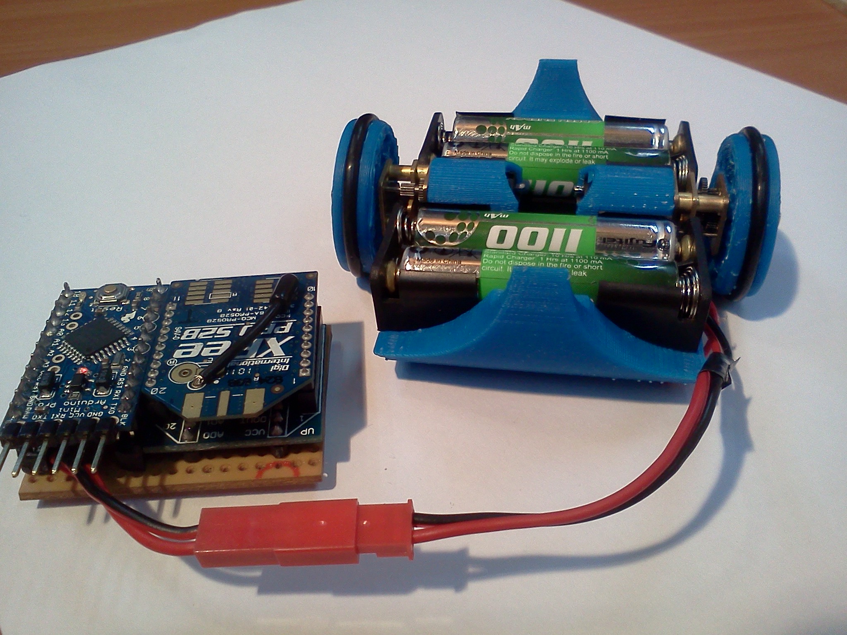
thesis/Pictures/3MODIrev2.jpg
