FabLabUChile/modi/thesis/Pictures/MDX20.jpg

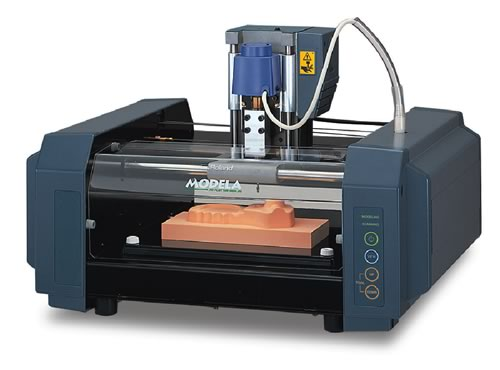
thesis/Pictures/MDX20.jpg
