FabLabUChile/modi/thesis/Pictures/MODIrev2.jpg

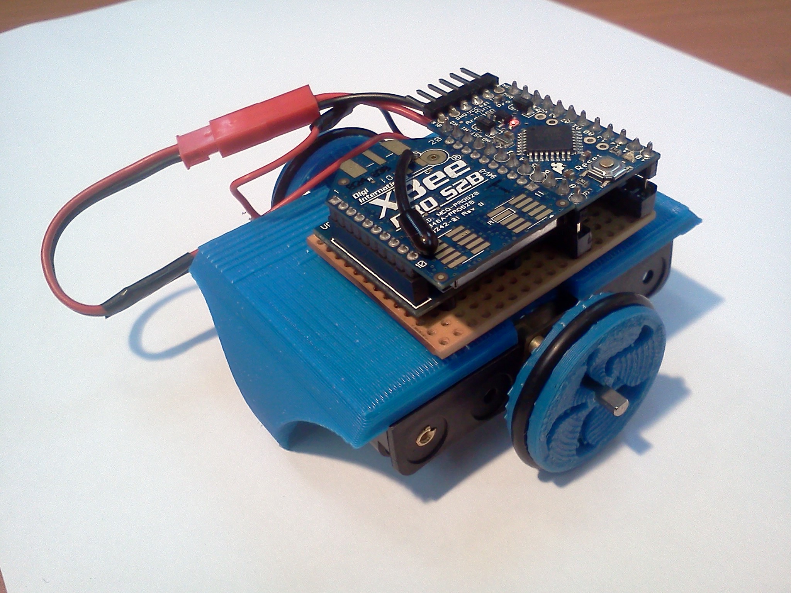
thesis/Pictures/MODIrev2.jpg
