FabLabUChile/modi/thesis/Pictures/pcb.jpg

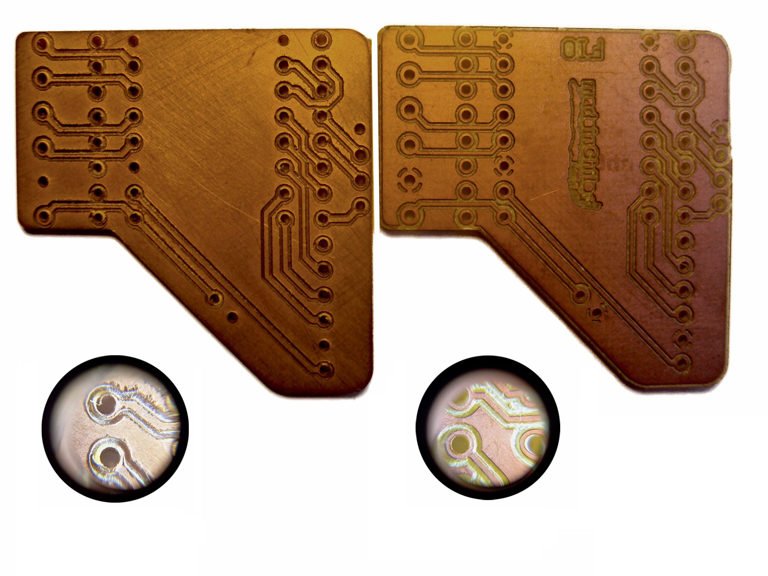
thesis/Pictures/pcb.jpg
