FabLabUChile/modi/thesis/Pictures/soldado2.jpg

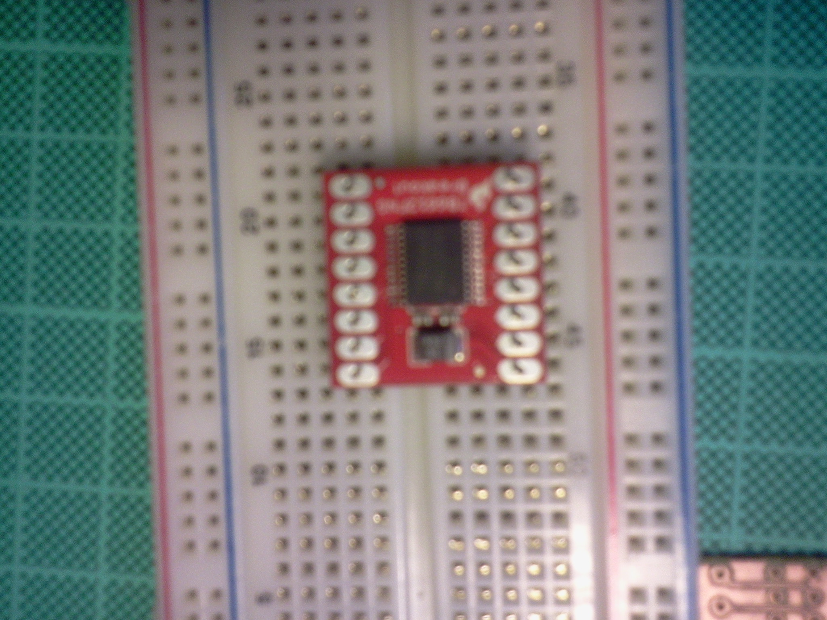
thesis/Pictures/soldado2.jpg
