FabLabUChile/modi/BOM.png

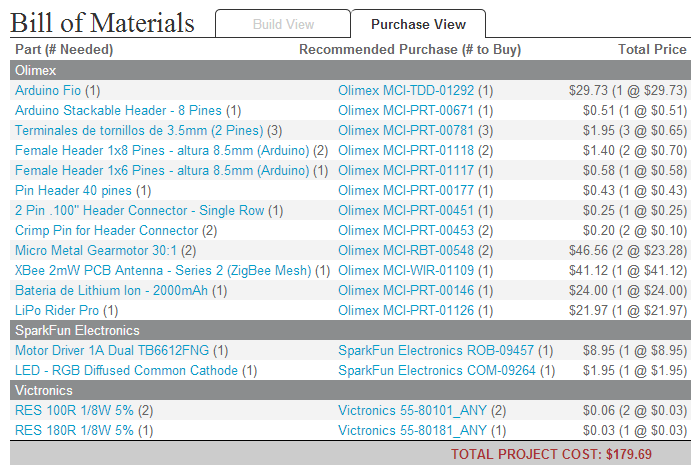
BOM.png
