FabLabUChile/modi/Hardware/inventor 2013/slt/Rueda.stl

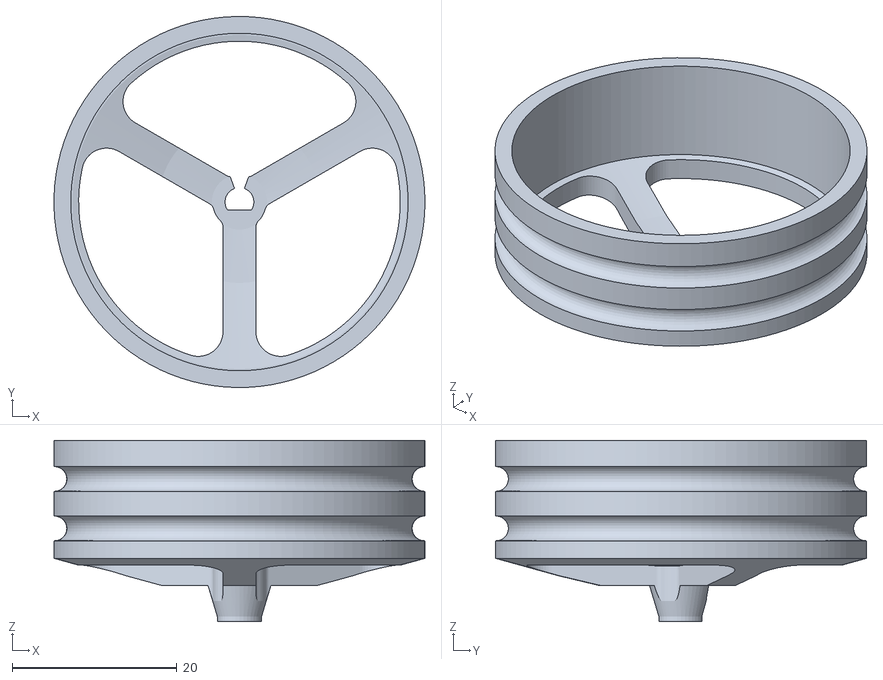
[picture p107: CAD file, 2013-07-11]
Hardware/inventor 2013/slt/Rueda.stl
45.0 x 45.0 x 22.0
