FabLabUChile/modi/Hardware/inventor 2013/slt/logo.stl

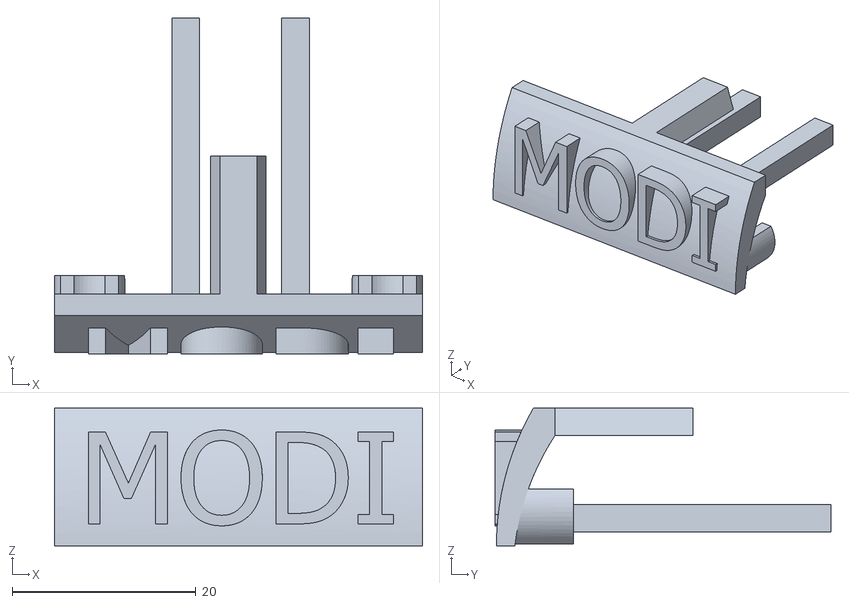
[picture p108: CAD file, 2013-07-11]
Hardware/inventor 2013/slt/logo.stl
40.0 x 36.5 x 15.0
