FabLabUChile/modi/Hardware/inventor 2013/slt/Chasis.stl

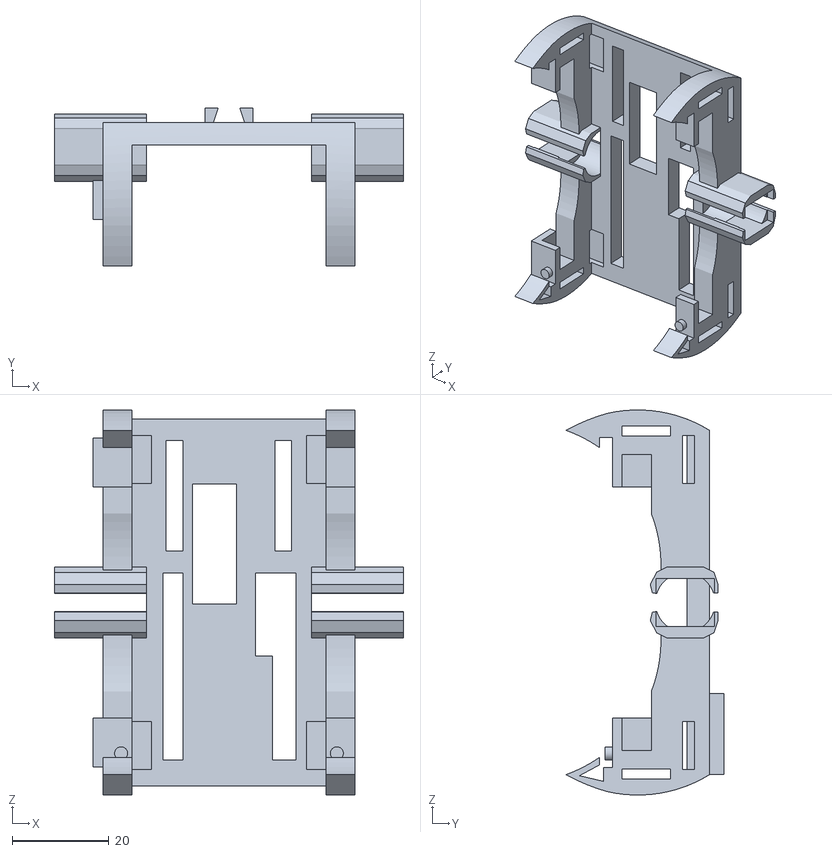
[picture p109: CAD file, 2013-07-11]
Hardware/inventor 2013/slt/Chasis.stl
72.0 x 32.6 x 79.4
