FabLabUChile/modi/(list of files, cad)

Other CAD files:
Hardware/inventor 2013/Adaptador TB6612FNG.ipt
Hardware/inventor 2013/Chasis.ipt
Hardware/inventor 2013/MODI.iam
Hardware/inventor 2013/OldVersions/Chasis.0024.ipt
Hardware/inventor 2013/OldVersions/MODI.0025.iam
Hardware/inventor 2013/Rueda.ipt
Hardware/inventor 2013/SoporteFio.ipt
Hardware/inventor 2013/bateria.ipt
Hardware/inventor 2013/fio.ipt
Hardware/inventor 2013/impresora3D.ipt
Hardware/inventor 2013/lipoRiderPro.ipt
Hardware/inventor 2013/logo.ipt
Hardware/inventor 2013/motor pololu.ipt
Hardware/inventor 2013/orings.ipt
Hardware/inventor 2013/tapa.ipt
