FabLabUChile/modi/thesis/Figures/MODI/ensamble2.png

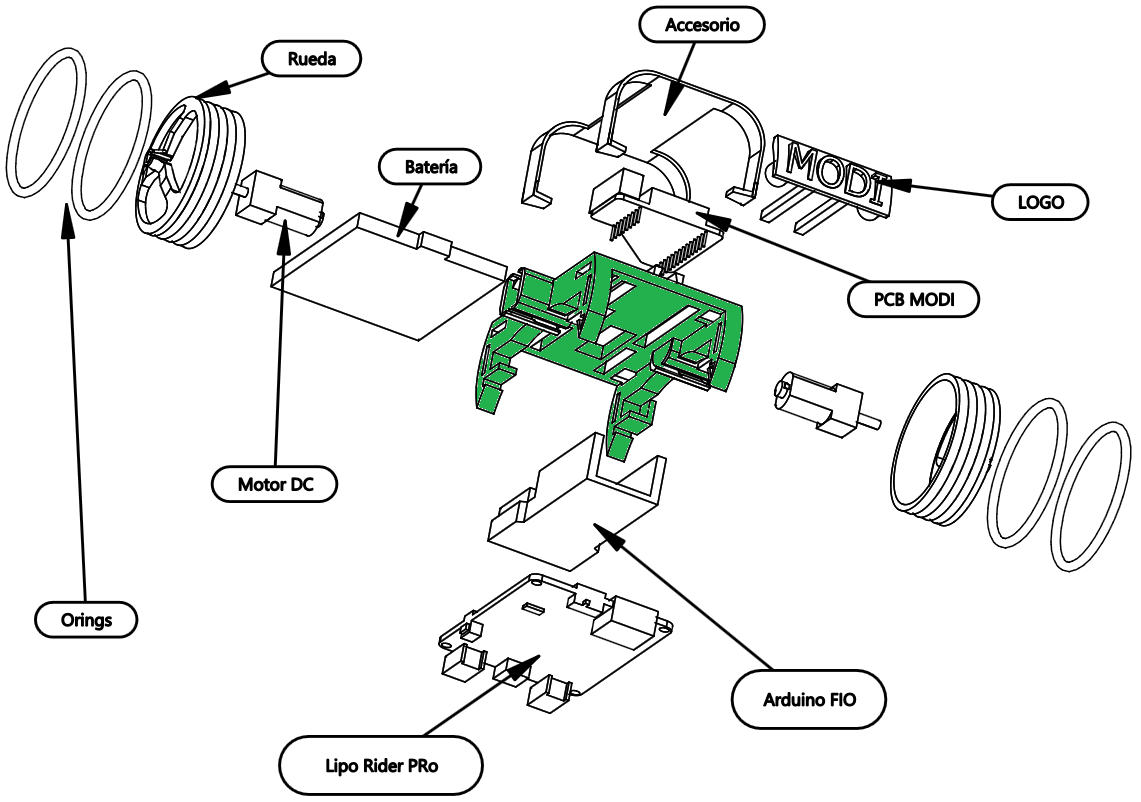
thesis/Figures/MODI/ensamble2.png
