FabLabUChile/modi/thesis/Figures/robotTest.png

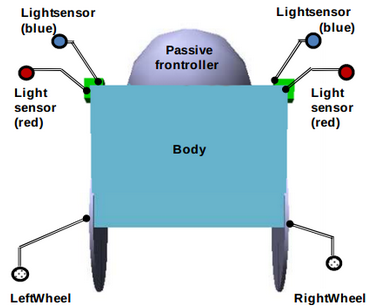
thesis/Figures/robotTest.png
