FabLabUChile/modi/(list of files, drawings)

Other design files:
Hardware/Fritzing/LED.fzz
Hardware/Fritzing/MODI.fzz
Hardware/Fritzing/MODI_without_LED.fzz
