FabLabUChile/modi/Hardware/Eagle/MODISLIM.brd

## EAGLE design Hardware/Eagle/MODISLIM.brd (2013-07-28)

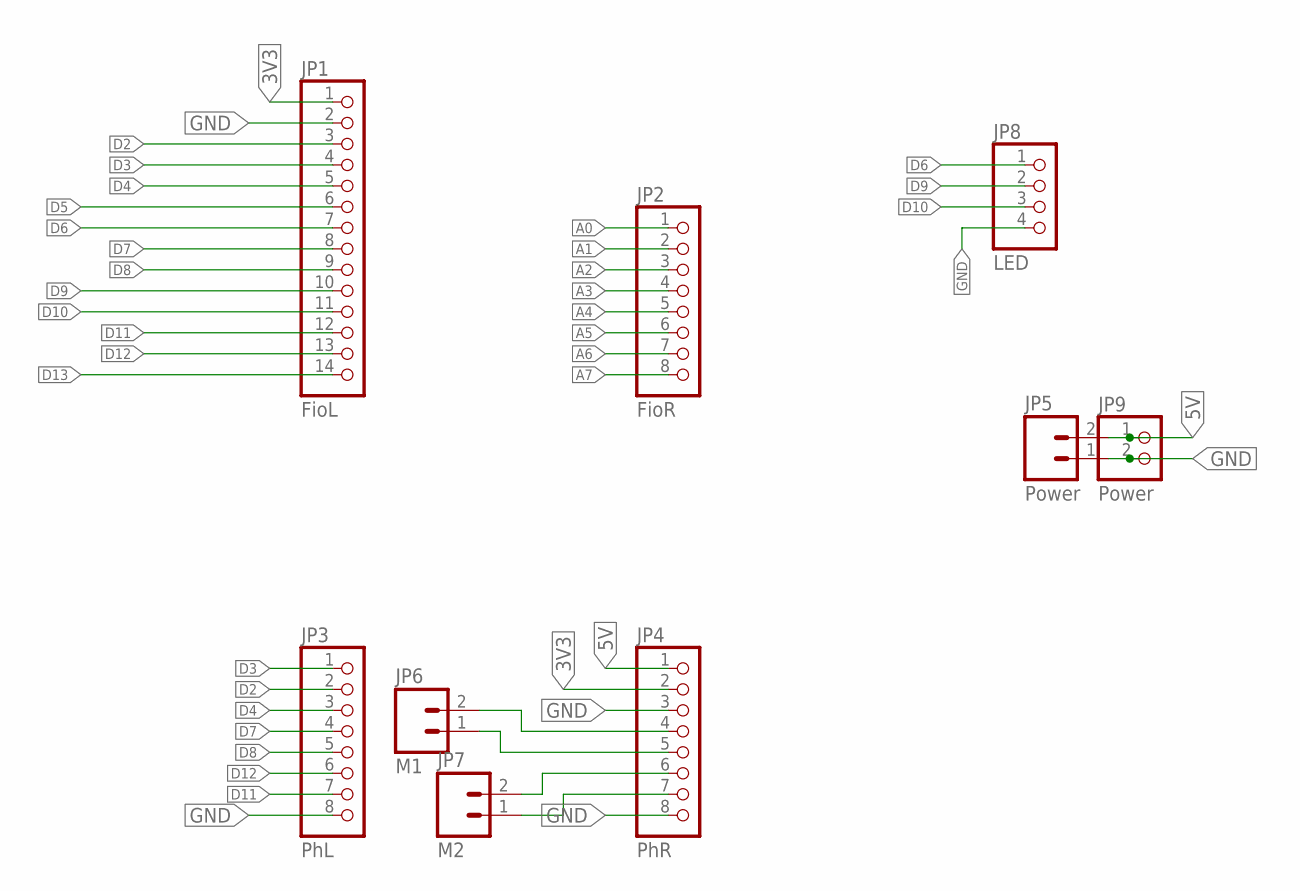
[picture p112: schematic MODISLIM.sch]

Parts:
JP1: FioL; 1X14
JP2: FioR; 1X08
JP3: PhL; 1X08
JP4: PhR; 1X08
JP5: Power; SCREWTERMINAL-3.5MM-2
JP6: M1; SCREWTERMINAL-3.5MM-2
JP7: M2; SCREWTERMINAL-3.5MM-2
JP8: LED; 1X04
JP9: Power; 1X02

Connections:
3V3: JP1.1, JP4.2
5V: JP4.1, JP5.2, JP9.1
A0: JP2.1
A1: JP2.2
A2: JP2.3
A3: JP2.4
A4: JP2.5
A5: JP2.6
A6: JP2.7
A7: JP2.8
D2: JP1.3, JP3.2
D3: JP1.4, JP3.1
D4: JP1.5, JP3.3
D5: JP1.6
D6: JP1.7, JP8.1
D7: JP1.8, JP3.4
D8: JP1.9, JP3.5
D9: JP1.10, JP8.2
D10: JP1.11, JP8.3
D11: JP1.12, JP3.7
D12: JP1.13, JP3.6
D13: JP1.14
GND: JP1.2, JP3.8, JP4.3, JP4.8, JP5.1, JP8.4, JP9.2
unnamed: JP4.7, JP7.1
unnamed: JP4.6, JP7.2
unnamed: JP4.5, JP6.1
unnamed: JP4.4, JP6.2

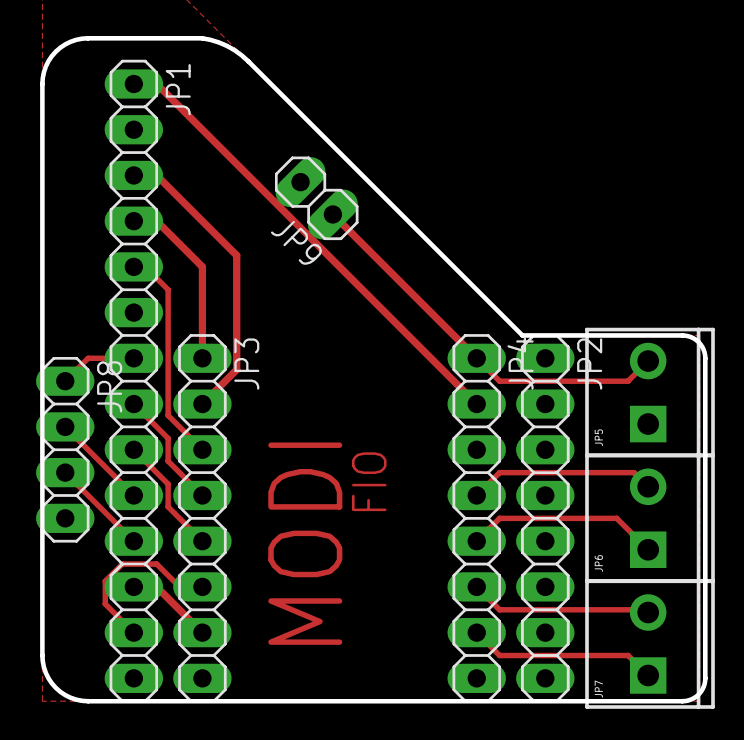
[picture p113: board MODISLIM.brd from above]

Board: 2 copper layers, 36.8 x 36.8 mm, 9 parts (0 on the bottom side), 17 nets.
