FabLabUChile/modi/Hardware/Eagle/MODI.brd

## EAGLE design Hardware/Eagle/MODI.brd (2012-11-20)

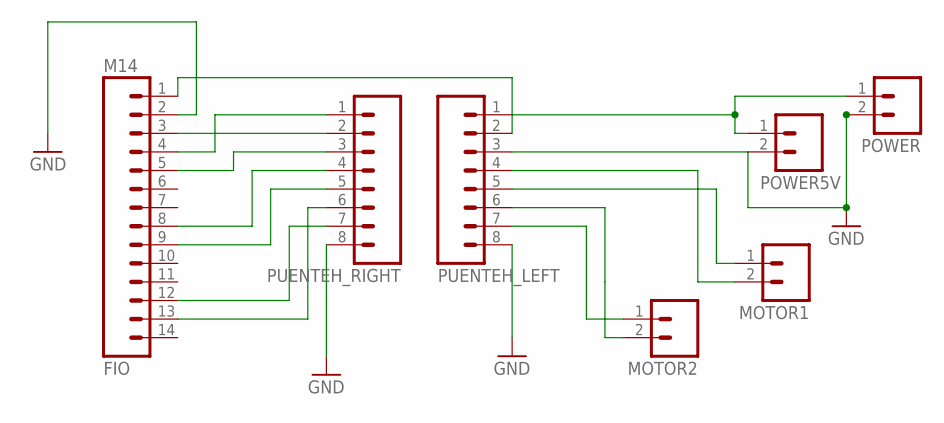
[picture p114: schematic MODI.sch]

Parts:
FIO: M14; 1X14
MOTOR1, MOTOR2: M023.5MM; SCREWTERMINAL-3.5MM-2
POWER: M023.5MM; SCREWTERMINAL-3.5MM-2
POWER5V: M02PTH; 1X02
PUENTEH_LEFT: M08LONGPADS; 1X08_LONGPADS
PUENTEH_RIGHT: M08LONGPADS; 1X08_LONGPADS

Connections:
5V: POWER.1, POWER5V.1, PUENTEH_LEFT.1
GND: FIO.2, POWER.2, POWER5V.2, PUENTEH_LEFT.3, PUENTEH_LEFT.8, PUENTEH_RIGHT.8
unnamed: FIO.3, PUENTEH_RIGHT.2
unnamed: FIO.4, PUENTEH_RIGHT.1
unnamed: FIO.5, PUENTEH_RIGHT.3
unnamed: FIO.12, PUENTEH_RIGHT.7
unnamed: FIO.8, PUENTEH_RIGHT.4
unnamed: FIO.9, PUENTEH_RIGHT.5
unnamed: FIO.13, PUENTEH_RIGHT.6
unnamed: MOTOR1.2, PUENTEH_LEFT.4
unnamed: MOTOR1.1, PUENTEH_LEFT.5
unnamed: MOTOR2.2, PUENTEH_LEFT.6
unnamed: MOTOR2.1, PUENTEH_LEFT.7
unnamed: FIO.1, PUENTEH_LEFT.2

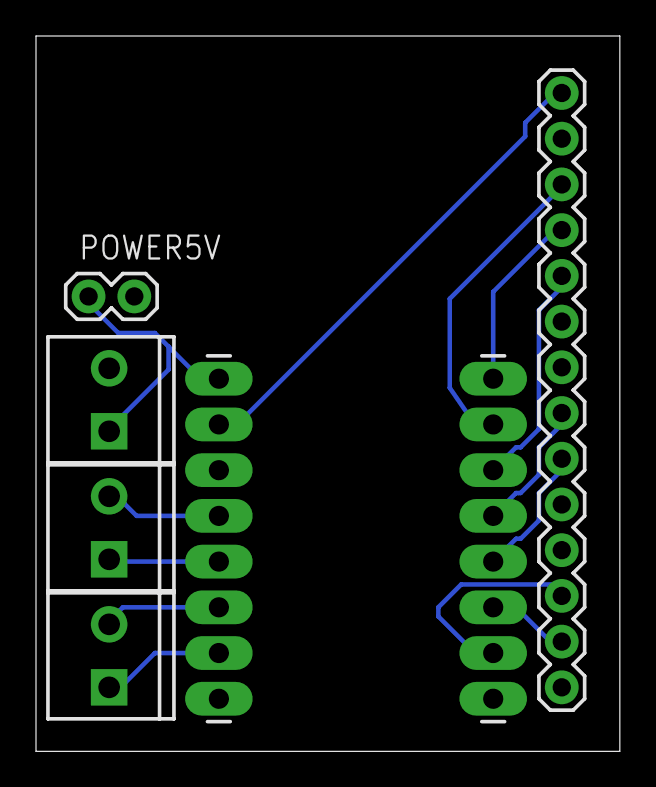
[picture p115: board MODI.brd from above]

Board: 2 copper layers, 32.4 x 39.7 mm, 7 parts (0 on the bottom side), 14 nets.
