FabLabUChile/modi/Software/Tracking/processing/TuioGetAngle/TuioGetAngle.pde

 /*
   Angle controll of MODI, based on TUIO example from 
    
    TUIO processing demo - part of the reacTIVision project
    http://reactivision.sourceforge.net/
    
    GNU License

*/

// we need to import the TUIO library
// and declare a TuioProcessing client variable
import java.util.*; 
import TUIO.*;
import processing.serial.*;

Serial myPort;  // Create object from Serial class
int val;        // Data received from the serial port

TuioProcessing tuioClient;

// these are some helper variables which are used
// to create scalable graphical feedback
float cursor_size = 15;
float object_size = 60;
float table_size = 760;
float scale_factor = 1;
float angleM;
PFont font;

void setup()
{
  //size(screen.width,screen.height);
  size(640,480);
  noStroke();
  fill(0);
  
  
  frameRate(5);
  //noLoop();
  

  font = createFont("Arial", 18);
  scale_factor = height/table_size;
  
  // we create an instance of the TuioProcessing client
  // since we add "this" class as an argument the TuioProcessing class expects
  // an implementation of the TUIO callback methods (see below)
  tuioClient  = new TuioProcessing(this);
  
  String portName = Serial.list()[0];
  myPort = new Serial(this, portName, 115200);
}

// within the draw method we retrieve a Vector (List) of TuioObject and TuioCursor (polling)
// from the TuioProcessing client and then loop over both lists to draw the graphical feedback.
void draw()
{
  background(255);
  textFont(font,18*scale_factor);
  float obj_size = object_size*scale_factor; 
  float cur_size = cursor_size*scale_factor; 
   
  Vector tuioObjectList = tuioClient.getTuioObjects();
  for (int i=0;i<tuioObjectList.size();i++) {
     TuioObject tobj = (TuioObject)tuioObjectList.elementAt(i);
     stroke(0);
     fill(0);
     pushMatrix();
     translate(tobj.getScreenX(width),tobj.getScreenY(height));
     rotate(tobj.getAngle());
     rect(-obj_size/2,-obj_size/2,obj_size,obj_size);
     drawArrow(0,0,50,0);
     popMatrix();
    
     fill(255);
     text(""+tobj.getSymbolID(), tobj.getScreenX(width), tobj.getScreenY(height));
     angleM = tobj.getAngleDegrees();
     print("angle ");
     println(int(angleM));
     
     float a = atan2(tobj.getScreenX(width)-width/2, tobj.getScreenY(height)-height/2);
     
     
     if (int(degrees(a) - angleM) > 10)
     {
       print("vector ");
       println(degrees(a) - angleM);
       myPort.write('d');
     }
     if (int(degrees(a) - angleM) < -10) 
     {
       print("vector ");
       println(degrees(a) - angleM);
       myPort.write('a');
     }
    float distance = dist (tobj.getScreenX(width), tobj.getScreenY(height), width/2, height/2);
     println(distance);
     //if (distance > 150)  myPort.write('w');
     
//     if (int(angleM) < 90) myPort.write('d');
//     if (int(angleM) > 100) myPort.write('a');

   }

    //  

   
   Vector tuioCursorList = tuioClient.getTuioCursors();
   for (int i=0;i<tuioCursorList.size();i++) {
      TuioCursor tcur = (TuioCursor)tuioCursorList.elementAt(i);
      Vector pointList = tcur.getPath();
      
      if (pointList.size()>0) {
        stroke(0,0,255);
        TuioPoint start_point = (TuioPoint)pointList.firstElement();;
        for (int j=0;j<pointList.size();j++) {
           TuioPoint end_point = (TuioPoint)pointList.elementAt(j);
           line(start_point.getScreenX(width),start_point.getScreenY(height),end_point.getScreenX(width),end_point.getScreenY(height));
           start_point = end_point;
        }
        
        stroke(192,192,192);
        fill(192,192,192);
        ellipse( tcur.getScreenX(width), tcur.getScreenY(height),cur_size,cur_size);
        fill(0);
        text(""+ tcur.getCursorID(),  tcur.getScreenX(width)-5,  tcur.getScreenY(height)+5);
      }
      
      
   }
   
}

// these callback methods are called whenever a TUIO event occurs

// called when an object is added to the scene
void addTuioObject(TuioObject tobj) {
  println("add object "+tobj.getSymbolID()+" ("+tobj.getSessionID()+") "+tobj.getX()+" "+tobj.getY()+" "+tobj.getAngle());
}

// called when an object is removed from the scene
void removeTuioObject(TuioObject tobj) {
  println("remove object "+tobj.getSymbolID()+" ("+tobj.getSessionID()+")");
}

// called when an object is moved
void updateTuioObject (TuioObject tobj) {
//  println("update object "+tobj.getSymbolID()+" ("+tobj.getSessionID()+") "+tobj.getX()+" "+tobj.getY()+" "+tobj.getAngle()
//          +" "+tobj.getMotionSpeed()+" "+tobj.getRotationSpeed()+" "+tobj.getMotionAccel()+" "+tobj.getRotationAccel());
          
          // println("update object "+tobj.getSymbolID()+" "+tobj.getAngleDegrees());

}

// called when a cursor is added to the scene
void addTuioCursor(TuioCursor tcur) {
  println("add cursor "+tcur.getCursorID()+" ("+tcur.getSessionID()+ ") " +tcur.getX()+" "+tcur.getY());
}

// called when a cursor is moved
void updateTuioCursor (TuioCursor tcur) {
  println("update cursor "+tcur.getCursorID()+" ("+tcur.getSessionID()+ ") " +tcur.getX()+" "+tcur.getY()
          +" "+tcur.getMotionSpeed()+" "+tcur.getMotionAccel());
}

// called when a cursor is removed from the scene
void removeTuioCursor(TuioCursor tcur) {
  println("remove cursor "+tcur.getCursorID()+" ("+tcur.getSessionID()+")");
}

// called after each message bundle
// representing the end of an image frame
void refresh(TuioTime bundleTime) { 
  redraw();
}

void drawArrow(int cx, int cy, int len, float angle){
  pushMatrix();
  translate(cx, cy);
  rotate(radians(angle));
  line(0,0,len, 0);
  line(len, 0, len - 8, -8);
  line(len, 0, len - 8, 8);
  popMatrix();
}
