FabLabUChile/modi/Software/MODI/Processing/Bounce/Bounce.pde

/**
 * Bounce. 
 * 
 * When the shape hits the edge of the window, it reverses its direction. 
 */
 

import processing.serial.*;

Serial myPort;  // Create object from Serial class
int val;        // Data received from the serial port

int rad = 90;        // Width of the shape
float xpos, ypos;    // Starting position of shape    

float xspeed = 2.8;  // Speed of the shape
float yspeed = 4.5;  // Speed of the shape

int xdirection = 1;  // Left or Right
int ydirection = 1;  // Top to Bottom


void setup() 
{
  size(320, 240);
  noStroke();
  frameRate(10);
  ellipseMode(RADIUS);
  // Set the starting position of the shape
  xpos = width/2;
  ypos = height/2;
  
  
  // I know that the first port in the serial list on my mac
  // is always my  FTDI adaptor, so I open Serial.list()[0].
  // On Windows machines, this generally opens COM1.
  // Open whatever port is the one you're using.
  String portName = Serial.list()[1];
  myPort = new Serial(this, portName, 115200);
  
}

void draw() 
{
  background(102);
   
  if (ydirection > 0) myPort.write('w'); 
  else myPort.write('s');
    
  if (xpos < (xpos + ( xspeed * xdirection ))) {
    myPort.write('d'); 

        }
    else {
     myPort.write('a');


    }
  // Update the position of the shape
  xpos = xpos + ( xspeed * xdirection );
  ypos = ypos + ( yspeed * ydirection );
  
 
  
  // Test to see if the shape exceeds the boundaries of the screen
  // If it does, reverse its direction by multiplying by -1
  if (xpos > width-rad || xpos < rad) {
    xdirection *= -1;

  }
  if (ypos > height-rad || ypos < rad) {
    ydirection *= -1;

  }


    

  // Draw the shape
  ellipse(xpos, ypos, rad, rad);
}
