FabLabUChile/modi/(commit log)

2012-11-20 Main project files added
    [MODI.SLDASM, MODI.STL, MODI.brd, MODI.sch, rim.SLDPRT]
2012-12-31 MODI control with Processing
    By testing the best Frame Rate it's 10
2012-12-31 trying to add x axis move
    not lucky yet
2013-01-02 New software -> new bodie
    [Ensamblaje1.iam, bateria.ipt, chasis.ipt, fio.ipt, lipoRiderPro.ipt]
2013-01-02 Revert "New software -> new bodie"
    This reverts commit d780a5ee8f13433e90e3e0d8301f1e04f5b20d63.
    [Ensamblaje1.iam, bateria.ipt, chasis.ipt, fio.ipt, lipoRiderPro.ipt]
2013-01-02 Revert "Revert "New software -> new bodie""
    This reverts commit 5717da78f8244d48f9b85d9ddb98ecb9a29f9ebb.
    [Ensamblaje1.iam, bateria.ipt, chasis.ipt, fio.ipt, lipoRiderPro.ipt]
2013-01-02 tope doble fix
    [Ensamblaje1.0003.iam, chasis.0003.ipt, chasis.ipt]
2013-01-03 Chasis mas solido
    [Ensamblaje1.0003.iam, Ensamblaje1.0004.iam, Ensamblaje1.iam, chasis.0003.ipt, chasis.0007.ipt, chasis.ipt]
2013-01-04 Ready for print
    [Ensamblaje1.0004.iam, Ensamblaje1.0007.iam, Ensamblaje1.iam, chasis.0007.ipt, chasis.0011.ipt, chasis.ipt]
2013-01-04 topes mas altos
    [Ensamblaje1.0007.iam, Ensamblaje1.0008.iam, Ensamblaje1.iam, chasis.0011.ipt, chasis.0013.ipt, chasis.ipt]
2013-01-05 New body -> new shoes
    New design with new wheels
    [Ensamblaje1.0008.iam, Ensamblaje1.0011.iam, Ensamblaje1.iam, Rueda.0002.ipt, Rueda.ipt, chasis.0013.ipt, chasis.0015.ipt, chasis.ipt]
2013-01-06 README de la seccion Software
    Describe lo que hay en la carpeta para que el uso sea mas guiado.
2013-01-07 fix wheels
    [Ensamblaje1.0011.iam, Ensamblaje1.0012.iam, Ensamblaje1.iam, Rueda.0002.ipt, Rueda.0004.ipt, Rueda.ipt]
2013-01-09 Fix Topes and wheels
    ...and add STL Files
    [Ensamblaje1.0012.iam, Ensamblaje1.0013.iam, Ensamblaje1.iam, Rueda.0004.ipt, Rueda.0007.ipt, Rueda.ipt, Rueda.stl, chasis.0015.ipt]
2013-01-09 Update STL
    [chasis.0020.ipt, chasis.0022.ipt, chasis.ipt, chasis.stl]
2013-01-09 more filled
    [Ensamblaje1.0013.iam, Ensamblaje1.0016.iam, Ensamblaje1.iam, chasis.0022.ipt, chasis.0027.ipt, chasis.ipt, chasis.stl]
2013-04-12 Add some Sweep
    [chasis.0035.ipt, chasis.0036.ipt, chasis.ipt]
2013-04-15 fix topes lipo rider pro
    [Ensamblaje1.0017.iam, Ensamblaje1.0018.iam, Ensamblaje1.iam, chasis.0036.ipt, chasis.0039.ipt, chasis.ipt, chasis.stl]
2013-04-19 fix some dimension
    [chasis.0039.ipt, chasis.0041.ipt, chasis.ipt, chasis.stl, soporte camara.ipt, soporte camara.stl, union pvc tubo.0003.ipt, union pvc tubo.ipt]
2013-04-24 new wheels
    [Ensamblaje1.0018.iam, Ensamblaje1.0020.iam, Ensamblaje1.iam, Rueda.0015.ipt, Rueda.0018.ipt, Rueda.ipt, Rueda.stl, bateria.0001.ipt]
2013-05-02 New Look
    [Chasis.0008.ipt, Chasis.ipt, Chasis.stl, Ensamblaje1.0020.iam, Ensamblaje1.0021.iam, Ensamblaje1.iam, MODI.0006.iam, MODI.iam]
2013-05-15 expansion board
    Add the expansion feature of chasis
    [Adaptador TB6612FNG.0001.ipt, Adaptador TB6612FNG.ipt, Chasis.0008.ipt, Chasis.0014.ipt, Chasis.ipt, Chasis.stl, LiPo Rider Pro v0.9b.brd, LiPo Rider Pro v0.9b.sch]
2013-05-22 swap motor direction
2013-05-28 renders y thesis
    [MODI.0014.iam, MODI.0015.iam, MODI.iam, Rueda.0023.ipt, Rueda.0024.ipt, Rueda.ipt, bateria.0002.ipt, bateria.ipt]
2013-06-03 todo listo para migrar
    [MODI.0015.iam, MODI.0016.iam, MODI.iam, SoporteFio.0003.ipt, SoporteFio.0004.ipt, SoporteFio.ipt]
2013-06-03 test cambio git
    [MODI.0016.iam, MODI.0017.iam, MODI.iam]
2013-07-02 Super intro thesis
    [Chasis.0017.ipt, Chasis.0019.ipt, Chasis.ipt, Rueda.0026.ipt, Rueda.0027.ipt, Rueda.ipt, logo.0004.ipt, logo.0005.ipt]
2013-07-09 chasis ok
    [Chasis.0024.ipt, Chasis.ipt]
2013-07-11 thesis almost ready
    [Adaptador TB6612FNG.ipt, Chasis.stl, MODI.0025.iam, MODI.iam, Rueda.stl, logo.stl]
2013-07-29 thesis
    Before big changes in chapter 3
    [MODI.fzz, MODI_without_LED.fzz]
